alleybeachelectric/K3_KIOSK/fab file release/tplace-tname.PNG

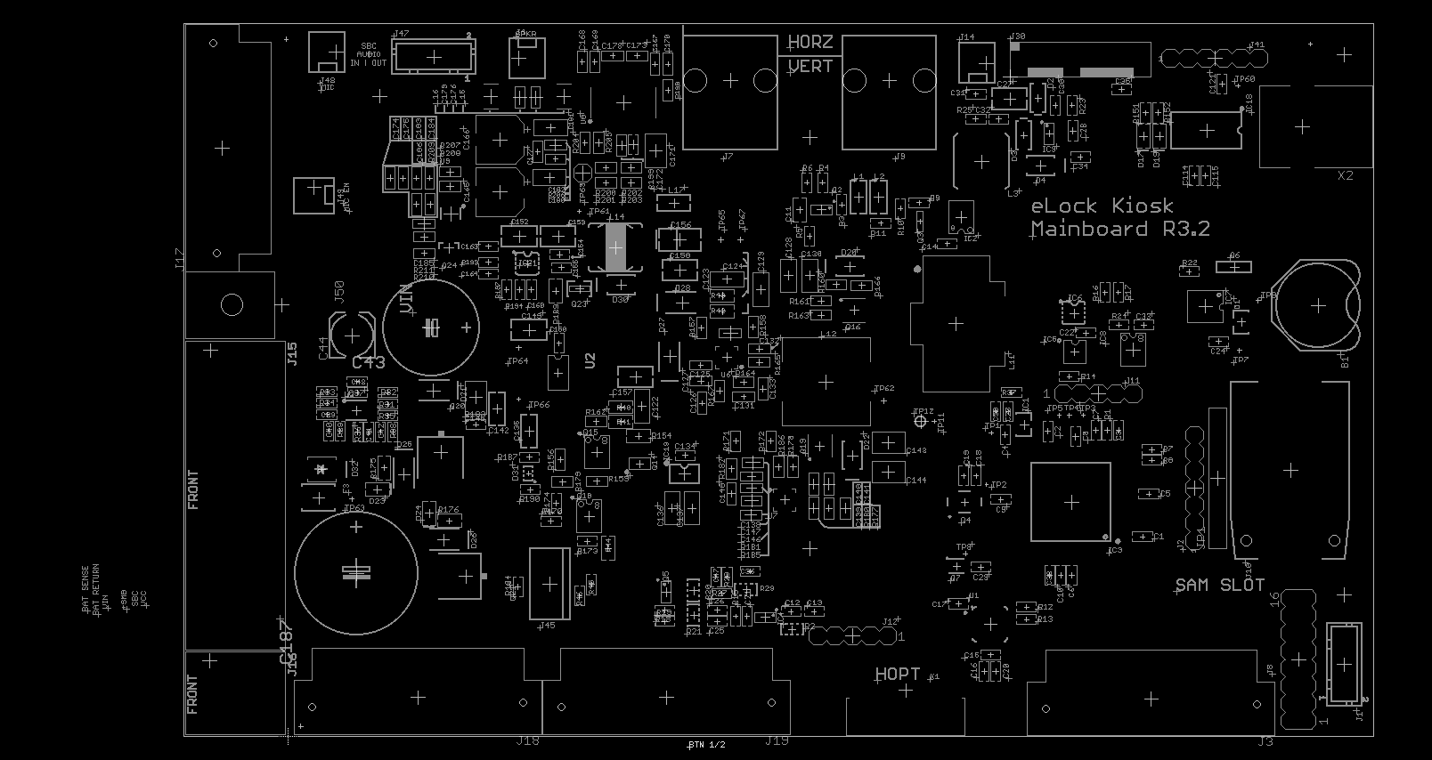
fab file release/tplace-tname.PNG
