alleybeachelectric/K3_KIOSK/fab file release/r3.3-05/BOM/PCB_KioskMB_r3.3-05 no attributes.csv

Qty | Value | Device | Package | Parts | Description
1 |  | P1-13 | P1-13@1 | TP69
4 |  | REF | REF | FID1, FID2, FID3, FID4
3 |  | ROUND_SMD0.7MM | SMD_ROUND_07MM | TP9, TP11, TP60 | Generic round SMD testpad
9 |  | ROUND_SMD1MM | SMD_ROUND_1MM | TP1, TP2, TP3, TP4, TP5, TP6, TP7, TP8, TP10 | Generic round SMD testpad
1 | FH12-22(10)SA-1SH | FH12-10S-0.5S1.00MM | CON-FPC-1.0MM-10POS | X1 | 0.5mm Pitch Connectors For FPC/FFC
5 | 0 | R-US_R0603 | R0603 | R16, R161, R163, R178, R180 | RESISTOR, American symbol
6 | 0.025R | R-0805 | 0805 | R40, R41, R42, R43, R44, R154
1 | 0.12R | R-0805 | 0805 | R189
26 | 0.1uF | C-0603 | 0603 | C2, C4, C5, C6, C17, C21, C22, C30, C33, C35, C37, C40, C42, C114, C121, C125, C126, C132, C139, C140, C147, C150, C154, C163, C167, C168
1 | 0.22R | R-0603 | 0603 | R26
5 | 0.47uF | C-0603 | 0603 | C173, C174, C175, C177, C178
1 | 0039301040 | 0039301040 | 0039301040 | J50 | MOLEX 2x2 Connector
2 | 0R | R-0603-0RTOP | 0603-0RTOP | R13, R15
4 | 1.0nF,50V | C-US-NP0603 | C0603 | C169, C170, C176, C179 | Capacitor, US symbol, non-polarized
5 | 10 | R-US_R0603 | R0603 | R157, R158, R171, R172, R198 | RESISTOR, American symbol
4 | 100K | R-0603 | 0603 | R7, R167, R186, R205
2 | 100pF | C-0603 | 0603 | C124, C138
1 | 100pF | C-US-NP0603 | C0603 | C146 | Capacitor, US symbol, non-polarized
10 | 10K | R-0603 | 0603 | R23, R25, R30, R31, R32, R33, R35, R162, R179, R193
8 | 10nF | C-0603 | 0603 | C12, C13, C25, C26, C36, C47, C134, C148
4 | 10uF,50V,1210 | C-US-NP1210 | C1210 | C143, C144, C145, C171 | Capacitor, US symbol, non-polarized
2 | 10uF/35V | C-1206 | 1206 | C135, C142
11 | 10uF/4V | C-0603 | 0603 | C3, C7, C9, C10, C23, C29, C38, C39, C41, C48, C59
1 | 120k | R-US_R0603 | R0603 | R209 | RESISTOR, American symbol
1 | 130pF,C0G | C-US-NP0603 | C0603 | C131 | Capacitor, US symbol, non-polarized
4 | 14011213102000 | 14011213102000 | 14011213102000 | J3, J17, J18, J19
1 | 15nF | C-US-NP0603 | C0603 | C133 | Capacitor, US symbol, non-polarized
1 | 15pF | C-0603 | 0603 | C160
2 | 178k,1% | R-US_R0603 | R0603 | R160, R177 | RESISTOR, American symbol
2 | 18pF | C-0603 | 0603 | C18, C19
1 | 1990737 | 1990737 | 1990737 | J16
1 | 1990834 | 1990834 | 1990834 | J15
3 | 1K | R-0603 | 0603 | R34, R36, R204
20 | 1M | R-0603 | 0603 | R3, R4, R5, R6, R9, R10, R11, R22, R24, R156, R159, R170, R173, R174, R183, R184, R197, R200, R201, R210
1 | 1nF | C-0603 | 0603 | C155
4 | 1u/10V | C-0603 | 0603 | C1, C8, C15, C24
1 | 1u/6.3V | C-0603 | 0603 | C14
2 | 1uF,25V | C-0603 | 0603 | C172, C182
3 | 1uF/16V | C-0603 | 0603 | C28, C31, C32
2 | 20.0k,1% | R-US_R0603 | R0603 | R166, R185 | RESISTOR, American symbol
1 | 22-11-2072 | HRXL-MAXSONAR-WRC-MB7387 | HRXL-MAXSONAR-WRC-MB7387 | J30
1 | 220pF | C-US-NP0603 | C0603 | C186 | Capacitor, US symbol, non-polarized
1 | 220uF, 16V, AL | CPOL-US153CLV-0605 | 153CLV-0605 | C44 | POLARIZED CAPACITOR, American symbol
2 | 220uF,16V,AL | CAP_ELEC_6.3MM_SMD | CAP_6.3MM_DIA_SMT | C165, C166
4 | 22u/16V | C-1210 | 1210 | C27, C149, C152, C153 | Capacitor 1210 3.2x2.5mm
9 | 22uF,25V,1206 | C-US-NP1206 | C1206 | C122, C123, C128, C129, C130, C136, C137, C180, C181 | Capacitor, US symbol, non-polarized
1 | 24LC32A-I/MS | 24-I/MS | MSOP-08 | IC6 | Serial EEPROM
1 | 2920L250DR | 1812L014DR | 1812 | F3 | PTC RESETTABLE 60V 140MA 1812L
1 | 2mF/16V | CPOL-USE7.5-18 | E7,5-18 | C187 | POLARIZED CAPACITOR, American symbol
4 | 3-641215-2 | 3-641215-2 | 3-641215-2 | J4, J14, J48, J49 | header 2 pin 100mil spacing
1 | 3-641215-4 | 3-641215-4 | 3-641215-4 | J45 | CONN HEADER VERT 4POS .100 30AU
1 | 3.09M | R-0603 | 0603 | R194
1 | 3.3K | R-0603 | 0603 | R207
2 | 3.3K | R-0805 | 0805 | R175, R176
3 | 3.3uF,16V | C-0603 | 0603 | C183, C184, C185
1 | 3.57K | R-0603 | 0603 | R8
1 | 3.9k | R-US_R0603 | R0603 | R211 | RESISTOR, American symbol
1 | 3001/3.3V | 3001 | 3001 | B1 | Through hole battery holder, 12mm cell, for BR1216, CR1216, BR1220, CL1220, CR1220, BR1225
2 | 300R | R-0603 | 0603 | R1, R37
1 | 330pF | C-0603 | 0603 | C164
1 | 33K | R-0603 | 0603 | R14
1 | 33R | R-0603 | 0603 | R206
1 | 4.7uF/16V | C-0805 | 0805 | C11
5 | 4.7uF/6.3V | C-0603 | 0603 | C16, C20, C115, C127, C141
1 | 470K | R-0603-0RTOP | 0603-0RTOP | R12
6 | 470R | R-0603 | 0603 | R38, R39, R45, R46, R151, R152
1 | 470uF/35-50V | CPOL-USE5-13 | E5-13 | C43 | POLARIZED CAPACITOR, American symbol
2 | 47K | R-0603 | 0603 | R187, R190
2 | 47uF/6.3V | C-1210 | 1210 | C157, C158 | Capacitor 1210 3.2x2.5mm
4 | 4x100K | EXB-38 | 0603-ARRAY | R2, R20, R21, R29 | Resistor array 4x
2 | 5.90K,1% | R-0603 | 0603 | R164, R181
1 | 6.8k | R-US_R0603 | R0603 | R208 | RESISTOR, American symbol
4 | 649R | R-0603 | 0603 | R18, R19, R27, R28
1 | 7B-28.63636MAAJ-T | 7B-27.120MAAJ-T | 7B | Q4 | Crystal 5x3.2mm, 18pF+-30ppm
2 | 93.1K,1% | R-0603 | 0603 | R165, R182
1 | ADS1015IDGS | ADS1015 | MSOP10 | U3 | 12-Bit Del-Sig ADC
1 | BAS70-05E6327 | BAS70-05E6327 | SOT-23 | D1 | Diode Schottky 70mA, 70V
1 | BAT54BRW-7F | BAT54BRW-7F | SOT-363 | D31 | DIODE SCHOTTKY 0.2A 30V ARR DL 30V SOT363
1 | BSS138 | BSS138 | SOT23 | Q24 | BSS138W N-chan MOSFET
1 | CCM03-3504LFT-NR | CCM03-3504LFT-NR | CCM03-3504LFT-NR | J10 | CONN SMART CARD FIXED 8PIN SMD
1 | CM519 32.768KDZF-UT | CM519 | CM519 | Q6
1 | CR75NP-220KC | CR75-330KC | CR75 | L14 | Inductor power, 27uH, 0.12R 1.3A, 33uH, 0.13R 1.2A
2 | CSD87331Q3D | TRANS_DUAL_NFET_HALF-BRQ3D | SON8_3.3X3.3_TI | Q16, Q19 | Dual n-chan MOSFETs half-bridge config, i.e. TI NexFET
2 | DF11-10DP-2DSA(01) | DF11-10DP-2DSA(01) | DF11-10DP-2DSA | J1, J47 | CONN HEADER 10POS 2MM PCB GOLD
2 | DNP | MA05-1 | MA05-1 | J11, J12
1 | DNP | MA06-1 | MA06-1 | J41
1 | DNP | MA07-1 | MA07-1 | J2
1 | DNP | PINHD-1X8LOCK | 1X08-LOCK | JP1 | PIN HEADER
2 | DNP | R-US_R0603 | R0603 | R202, R203 | RESISTOR, American symbol
1 | DNP | STPS0540Z | SOD-123 | D2 | Schottky diode 0.4V@0.5A 40Vrr, low Irr
1 | FDC6330L | FDC6324L | SSOT-6 | Q5 | IC LOAD SWITCH INT 20VIN SSOT-6
1 | FDC6330L | FDC6330L | SSOT-6 | Q2 | IC LOAD SWITCH INT 20VIN SSOT-6, 80mOhm, 2.5A
1 | FDN352AP | FDN352AP | SOT-23 | Q23 | MOSFET P 30V 1.3A 180mOhm@-10V
1 | FT232RL | FT232RL | SSOP28DB | IC18 | USB 2.0 to RS232 transfer interface IC
3 | HI1206T500R-00 | L-1206 | 1206 | L1, L2, L17
2 | HI1812V101R-10 | L1812 | L1812 | L15, L16 | Inductor, two pin
2 | IPD30N06S2L-23 | IPD30N06S2L-23 | TO252 | Q20, Q21 | MOSFET-N 55V 30A 0.023ohm
1 | ISL60002DIH325Z-TK | ISL60002DIH325Z-TK | SOT-23 | IC1 | Precision Low power V ref. Iq=350nA Vout=2.5V
1 | LE33CD | LE33 | LE33 | U2
4 | LED-GR | LED-0805 | 0805-POL | D17, D19, D23, D24
1 | LM3405AXMK/NOPB | LM3405AXMK/NOPB | SOT23-6 | IC9 | IC LED DRVR HP CONST TSOT23-6
1 | LM75ADP | LM75ADP | TSSOP08-3 | IC5 | Digital temperature sensor and thermal watchdog
1 | LTC1771EMS8 | LTC1771EMS8 | MSOP-08 | IC21 | Hi efficiency DCDC step down
1 | LTC1955 | LTC1955 | LFCSP_5X5_032 | U1 | Dual Smart Card interface with Serial control
1 | M25P16-VMN6P | M25P16-VMN6P | SO-08 | IC8 | 16Mbit low voltage SPI Flash
1 | MAX9938HEUK | TSM9938HEUK+T | SOT23-5 | Q14 | IC OPAMP CURRENT SENSE SOT23-5
1 | MCP602-I/ST | MCP6022-I/ST | TSSOP8 | IC19 | OPAMP 10MHz Vofset=0.5V
1 | MINI-USB_4P-85-32004-10X | MINI-USB_4P-85-32004-10X | 85-32004-10X | X2 | MINI USB 4 Pol.
1 | NRS8030T150MJGJ | NRS8030T150MJGJ | NRS8030 | L3 | Inductor power 150: 15uH 2.2A
1 | OPA322SAIDBVT | IC_TI_OPA322SAIDBV | SOT23-6 | U9 | TI OPA322S opamp with shutdown
1 | P6SMB16A | P6SMB16A | SMB | D32 | TVS Unidirectional 13.6V, 15.2-16.8V breakdown
1 | PCF2123TS/1-T | PCF2123TS/1-T | TSSOP014 | IC7 | RTC chip low power
1 | PIC10F200T-I/OT | PIC10F200T-I/OT | SOT23-6 | IC4 | IC MCU Flash 256B of FLASH
1 | PIC24FJ256GA110-I/PT | PIC24FJ256GA110-I/PT | SQFP-S-12X12-100 | IC3 | PIC24FJ256GA110
4 | PMEG3030BEP | PMEG3030BEP | SOD-128 | D4, D20, D22, D30 | DIODE SCHOTTKY 30V 3A SOD128
1 | SER2013-472MLD | LSER20XX | L_SER20XX | L11 | Inductor, two pin
2 | SI4564DY | SI4564DY | SO-08 | Q15, Q18 | MOSFET N/P-CH 40V 10A 8SOIC
1 | SMAJ26A | SMAJ5.0A | SMA | D21 | TVS 400W 5.0 Breakdown 6.40-7.25V
1 | SMAJ5.0A | SMAJ5.0A | SMA | D28 | TVS 400W 5.0 Breakdown 6.40-7.25V
1 | SMLVT3V3 | SMLVT3V3 | SMA | D27 | TVS 600W 4.1 Breakdown
1 | SN65HVD12D | SN65HVD3082ED | SO08 | IC2 | RS-422/485 TRX 1RX 1TX
1 | SR3.3.TCT | SR05.TCT | SOT-143 | Q3 | IC TVS ARRAY 2-LINE 5V SOT-143
1 | SRR1280-150M | LSRR1280 | L_SRR1280 | L12 | Inductor, two pin
2 | SS-6566-NF | SS-6566-NF | SS-6566-NF | J7, J9 | AMP CONNECTOR
2 | SS14 | SS14 | SMA | D25, D26 | Diode schottky If=1A
1 | SSM6P49NU,LFPZ | SSM6P49NU,LFPZ | MICRO_FET | Q7 | MOSFET P-CH DUAL 30V UDFN6, 4A, 20V
5 | STANDOFF_ELECTRICAL | STANDOFF_ELECTRICAL | STANDOFF-ELECTRICAL | H1, H2, H3, H4, H5 | Stand Off
1 | STPS0540Z | STPS0540Z | SOD-123 | D3 | Schottky diode 0.4V@0.5A 40Vrr, low Irr
1 | TCJB157M006R0045 | C-POL-3528 | 3528-POL | C156
1 | TPA3111D1PWP | IC_TI_TPA3111D1PWP | TSSOP28_EP | U8 | TI TPA3111D1 amp
7 | TPB1,27 | TPB1,27 | B1,27 | TP61, TP62, TP63, TP64, TP65, TP66, TP67 | Test pad
2 | TPS43061 | IC_TI_TPS43061RTE | QFN16_3X3_EP | U6, U7 | TI TPS43061 boost converter
1 | TP_0812 | TP_0812 | TP_0.8_1.2 | TP12 | Testpad hole 0.8mm (32mil)
1 | TSW-108-07-G-D | MA08-2 | MA08-2 | J8
1 | dnp | C-0603 | 0603 | C34
