alleybeachelectric/K3_KIOSK/BOARD FILES/PCB_KioskMB_r3.2.dxf

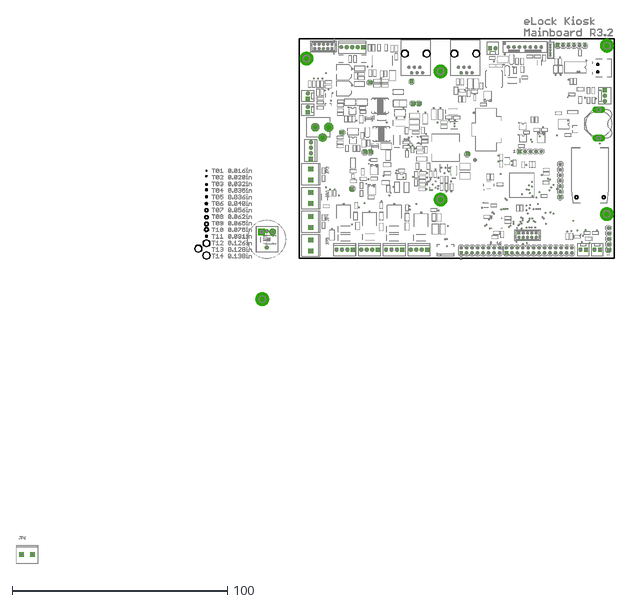
[picture p2: CAD file, 2017-05-18]
BOARD FILES/PCB_KioskMB_r3.2.dxf
277.7 x 254.3
