alleybeachelectric/K3_KIOSK/PDF's/PCB_KioskMB_r3.2- fixed FPC connector.dxf

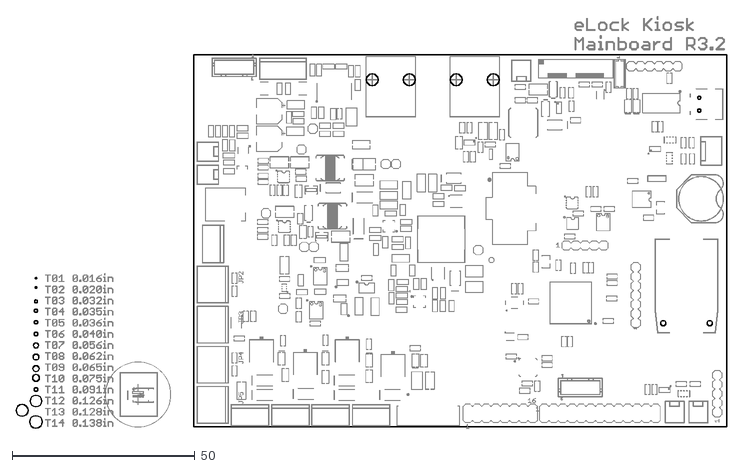
[picture p3: CAD file, 2017-05-18]
PDF's/PCB_KioskMB_r3.2- fixed FPC connector.dxf
194.7 x 113.0
