alleybeachelectric/K3_KIOSK/PDF's/PCB_KioskMB_r3.3-03 SILK 3.pdf

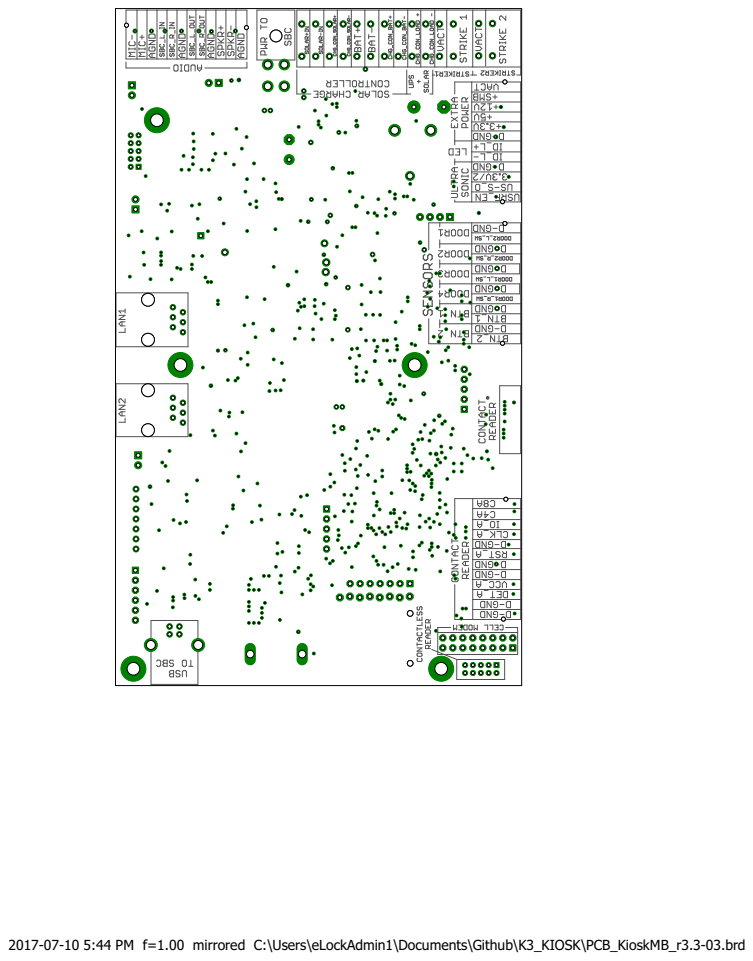
[picture p4: page 1]

2017-07-10 5:44 PM f=1.00 mirrored C:\Users\eLockAdmin1\Documents\Github\K3_KIOSK\PCB_KioskMB_r3.3-03.brd
