alleybeachelectric/K3_KIOSK/PDF's/PCB_KioskMB_r3.3-03 SILK4.pdf

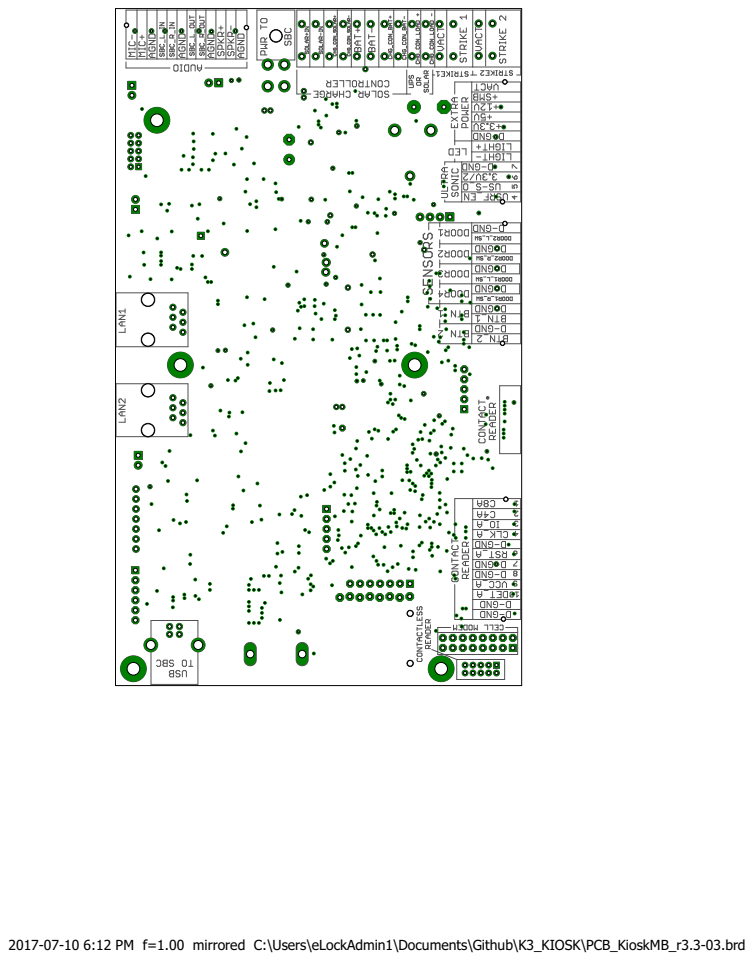
[picture p6: page 1]

2017-07-10 6:12 PM f=1.00 mirrored C:\Users\eLockAdmin1\Documents\Github\K3_KIOSK\PCB_KioskMB_r3.3-03.brd
