alleybeachelectric/K3_KIOSK/BOARD FILES/PCB_KioskMB_r3.3-04.brd

## EAGLE design BOARD FILES/PCB_KioskMB_r3.3-04.brd (2017-07-11)

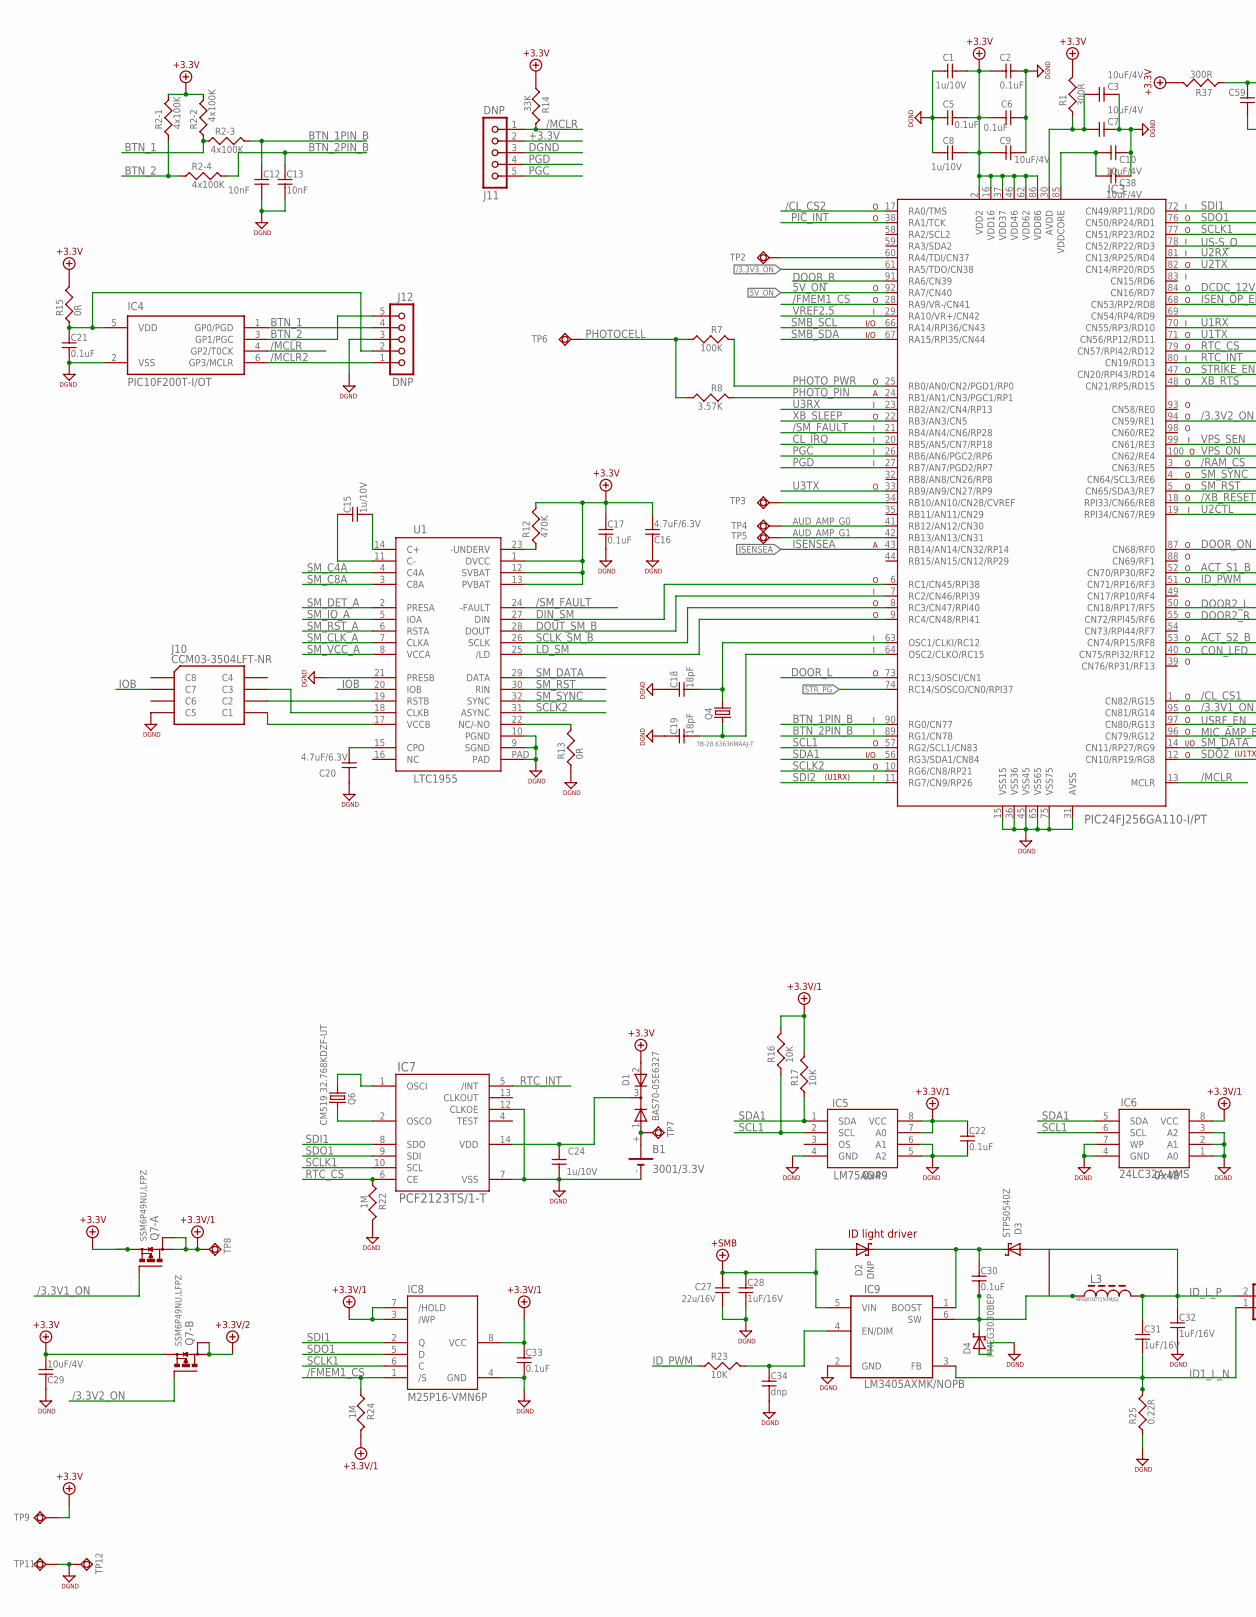
[picture p11: schematic PCB_KioskMB_r3.3-04.sch, sheet 1, part in row 1, column 1]

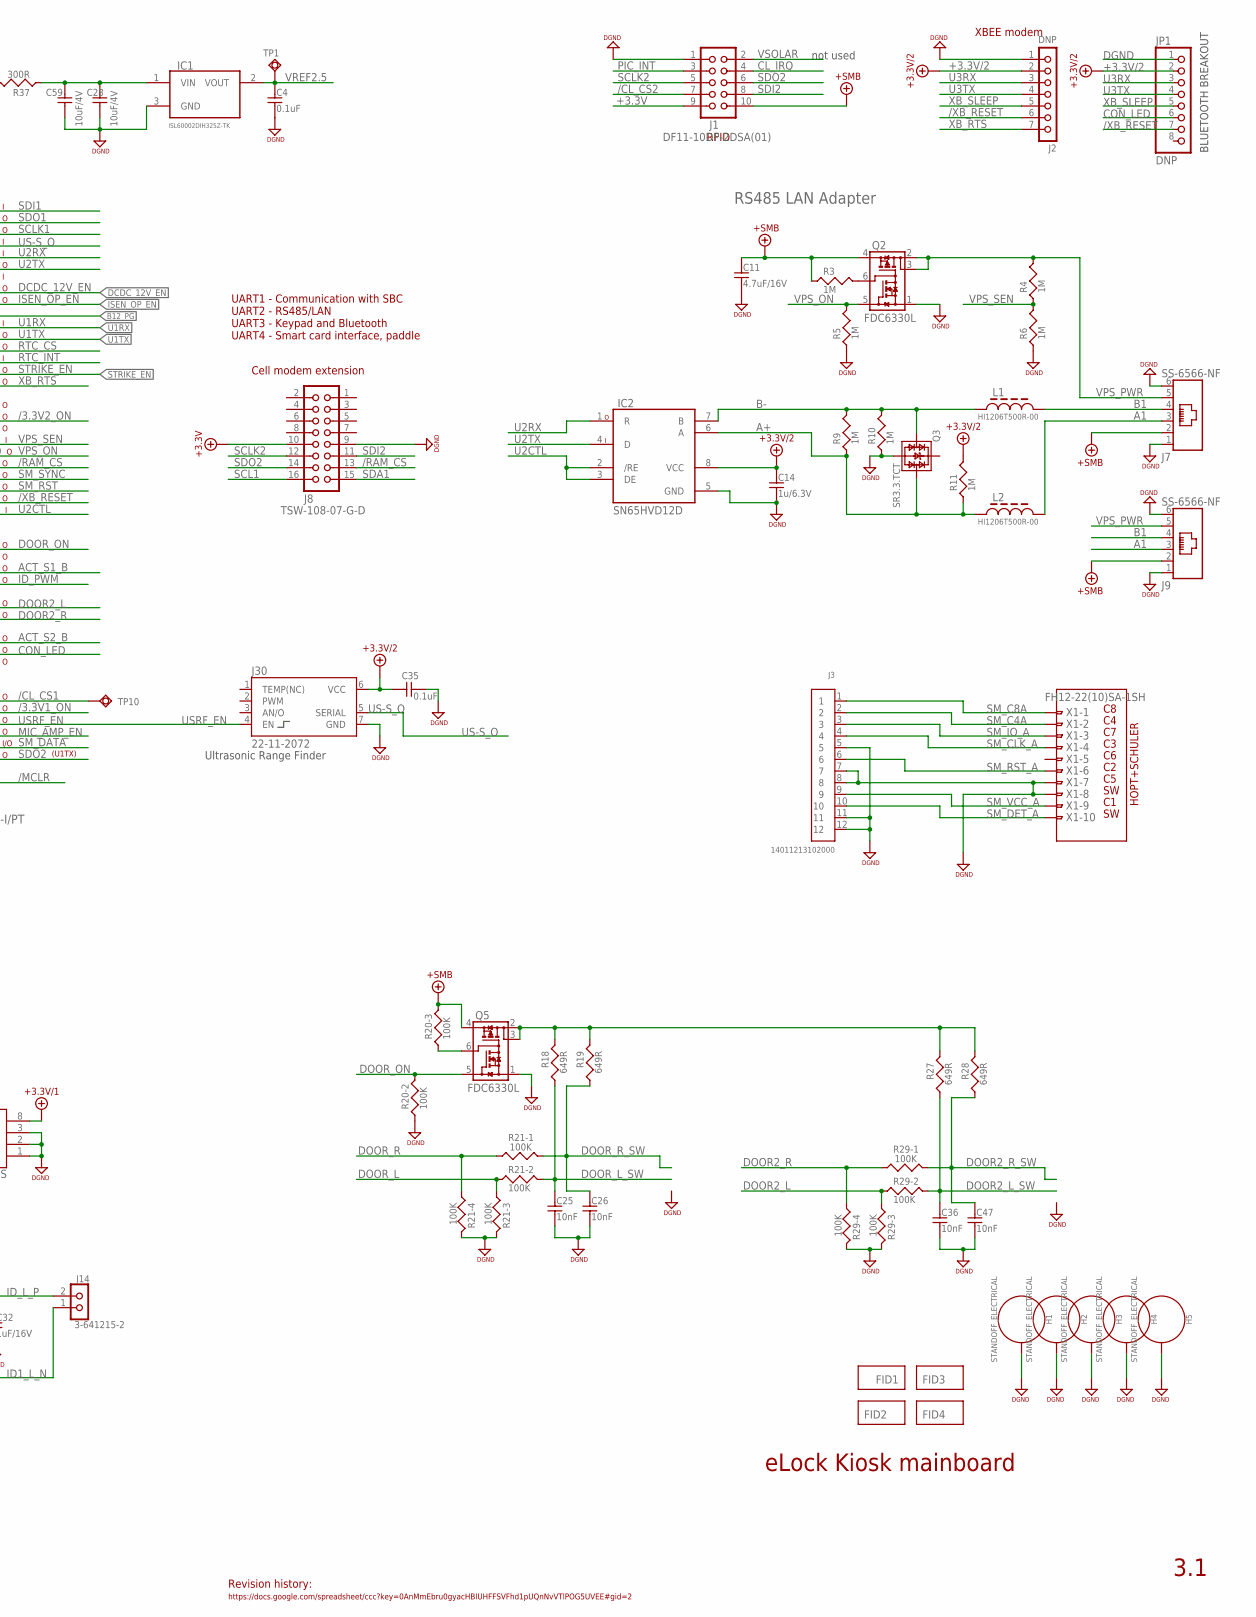
[picture p12: schematic PCB_KioskMB_r3.3-04.sch, sheet 1, part in row 1, column 2]

Parts:
B1: 3001/3.3V; 3001
C1, C8, C15, C24: 1u/10V; 0603
C2, C4, C5, C6, C17, C21, C22, C30, C33, C35: 0.1uF; 0603
C3, C7, C9, C10, C23, C29, C38, C59: 10uF/4V; 0603
C11: 4.7uF/16V; 0805
C12, C13, C25, C26, C36, C47: 10nF; 0603
C14: 1u/6.3V; 0603
C16, C20: 4.7uF/6.3V; 0603
C18, C19: 18pF; 0603
C27: 22u/16V; 1210
C28, C31, C32: 1uF/16V; 0603
C34: dnp; 0603
D1: BAS70-05E6327; SOT-23
D2: DNP; SOD-123
D3: STPS0540Z; SOD-123
D4: PMEG3030BEP; SOD-128
FID1, FID2, FID3, FID4: REF
H1, H2, H3, H4, H5: STANDOFF_ELECTRICAL; STANDOFF-ELECTRICAL
IC1: ISL60002DIH325Z-TK; SOT-23
IC2: SN65HVD12D; SO08
IC3: PIC24FJ256GA110-I/PT; SQFP-S-12X12-100
IC4: PIC10F200T-I/OT; SOT23-6
IC5: LM75ADP; TSSOP08-3
IC6: 24LC32A-I/MS; MSOP-08
IC7: PCF2123TS/1-T; TSSOP014
IC8: M25P16-VMN6P; SO-08
IC9: LM3405AXMK/NOPB; SOT23-6
J1: DF11-10DP-2DSA(01); DF11-10DP-2DSA
J2: DNP; MA07-1
J3: 14011213102000
J7, J9: SS-6566-NF
J8: TSW-108-07-G-D; MA08-2
J10: CCM03-3504LFT-NR
J11, J12: DNP; MA05-1
J14: 3-641215-2
J30: 22-11-2072; HRXL-MAXSONAR-WRC-MB7387
JP1: DNP; 1X08-LOCK
L1, L2: HI1206T500R-00; 1206
L3: NRS8030T150MJGJ; NRS8030
Q2, Q5: FDC6330L; SSOT-6
Q3: SR3.3.TCT; SOT-143
Q4: 7B-28.63636MAAJ-T; 7B
Q6: CM519 32.768KDZF-UT; CM519
Q7: SSM6P49NU,LFPZ; MICRO_FET
R1, R37: 300R; 0603
R2: 4x100K; 0603-ARRAY
R3, R4, R5, R6, R9, R10, R11, R22, R24: 1M; 0603
R7: 100K; 0603
R8: 3.57K; 0603
R12: 470K; 0603-0RTOP
R13, R15: 0R; 0603-0RTOP
R14: 33K; 0603
R16, R17, R23: 10K; 0603-0RTOP
R18, R19, R27, R28: 649R; 0603
R20, R21, R29: 100K; 0603-ARRAY
R25: 0.22R; 0603-0RTOP
TP1, TP2, TP3, TP4, TP5, TP6, TP7, TP8, TP10: ROUND_SMD1MM; SMD_ROUND_1MM
TP9, TP11: ROUND_SMD0.7MM; SMD_ROUND_07MM
TP12: TP_0812; TP_0.8_1.2
U1: LTC1955; LFCSP_5X5_032
X1: FH12-22(10)SA-1SH; CON-FPC-1.0MM-10POS

Connections:
5V_ON: IC3.92 (RA7/CN40); also elsewhere on the board
+3.3V: C1.1, C2.1, C5.1, C6.1, C8.1, C9.1, C16.2, C17.1, C29.2, D1.2 (A2), IC3.2 (VDD2), IC3.16 (VDD16), IC3.37 (VDD37), IC3.46 (VDD46), IC3.62 (VDD62), IC3.86 (VDD86), J1.9, J8.10, J11.2, Q7.1 (S), Q7.4 (S), R1.2, R2.7 (2), R2.8 (2), R12.2, R14.2, R15.2, R37.2, TP9.P$1, U1.1 (DVCC), U1.12 (SVBAT), U1.13 (PVBAT); also elsewhere on the board
+3.3V/1: C22.1, C33.1, IC5.7 (A0), IC5.8 (VCC), IC6.8 (VCC), IC8.3 (/WP), IC8.7 (/HOLD), IC8.8 (VCC), Q7.6 (D), Q7.P1 (D1), R16.2, R17.2, R24.1, TP8.P$1; also elsewhere on the board
+3.3V/2: C14.1, C35.2, IC2.8 (VCC), J2.2, J30.6 (VCC), JP1.2, Q7.3 (D), Q7.P2 (D1), R11.2; also elsewhere on the board
+SMB: C11.1, C27.1, C28.1, D2.A, IC9.5 (VIN), J1.10, J7.2, J9.2, Q2.4 (Q2S), Q5.4 (Q2S), R3.1, R20.6 (2); also elsewhere on the board
/3.3V1_ON: IC3.95 (CN81/RG14), Q7.2 (G)
/3.3V2_ON: IC3.94 (CN59/RE1), Q7.5 (G)
/3.3V3_ON: IC3.61 (RA5/TDO/CN38)
/CL_CS1: IC3.1 (CN82/RG15), TP10.P$1
/CL_CS2: IC3.17 (RA0/TMS), J1.7
/FMEM1_CS: IC3.28 (RA9/VR-/CN41), IC8.1 (/S), R24.2
/MCLR: IC3.13 (MCLR), IC4.4 (GP2/T0CK), J11.1, R14.1
/MCLR2: IC4.6 (GP3/MCLR), J12.1
/RAM_CS: IC3.3 (CN63/RE5), J8.13
/SM_FAULT: IC3.21 (RB4/AN4/CN6/RP28), U1.24 (-FAULT)
/XB_RESET: IC3.18 (RPI33/CN66/RE8), J2.6, JP1.7
A1: J7.3, J9.3, L2.2
A+: IC2.6 (A), L2.1, Q3.3, R9.1, R11.1
ACT_S1_B: IC3.52 (CN70/RP30/RF2); also elsewhere on the board
ACT_S2_B: IC3.53 (CN74/RP15/RF8); also elsewhere on the board
AUD_AMP_G0: IC3.41 (RB12/AN12/CN30), TP4.P$1; also elsewhere on the board
AUD_AMP_G1: IC3.42 (RB13/AN13/CN31), TP5.P$1; also elsewhere on the board
B1: J7.4, J9.4, L1.2
B12_PG: IC3.69 (CN54/RP4/RD9); also elsewhere on the board
B-: IC2.7 (B), L1.1, Q3.2, R9.2, R10.2
BTN_1: IC4.1 (GP0/PGD), J12.4, R2.2 (1), R2.3 (1); also elsewhere on the board
BTN_1PIN_B: C12.1, IC3.90 (RG0/CN77), R2.6 (2)
BTN_2: IC4.3 (GP1/PGC), J12.5, R2.1, R2.4 (1); also elsewhere on the board
BTN_2PIN_B: C13.1, IC3.89 (RG1/CN78), R2.5 (2)
CL_IRQ: IC3.20 (RB5/AN5/CN7/RP18), J1.4
CON_LED: IC3.40 (CN75/RPI32/RF12), JP1.6
DCDC_12V_EN: IC3.84 (CN16/RD7); also elsewhere on the board
DGND: B1.-, C1.2, C2.2, C3.2, C4.2, C5.2, C6.2, C7.2, C8.2, C9.2, C10.1, C11.2, C12.2, C13.2, C14.2, C16.1, C17.2, C18.1, C19.1, C20.1, C21.2, C22.2, C23.2, C24.2, C25.2, C26.2, C27.2, C28.2, C29.1, C32.2, C33.2, C34.2, C35.1, C36.2, C38.1, C47.2, C59.2, D4.A, H1.P1, H2.P1, H3.P1, H4.P1, H5.P1, IC1.3 (GND), IC2.5 (GND), IC3.15 (VSS15), IC3.31 (AVSS), IC3.36 (VSS36), IC3.45 (VSS45), IC3.65 (VSS65), IC3.75 (VSS75), IC4.2 (VSS), IC5.4 (GND), IC5.5 (A2), IC5.6 (A1), IC6.1 (A0), IC6.2 (A1), IC6.3 (A2), IC6.4 (GND), IC6.7 (WP), IC7.7 (VSS), IC7.12 (CLKOE), IC8.4 (GND), IC9.2 (GND), J1.1, J2.1, J3.5, J3.7, J3.8, J3.11, J3.12, J7.1, J7.6, J8.9, J9.1, J9.6, J10.C5, J11.3, J12.3, J30.7 (GND), JP1.1, Q2.1 (Q1S), Q3.1, Q5.1 (Q1S), R5.1, R6.1, R10.1, R13.1, R20.2 (1), R21.5 (2), R21.6 (2), R22.1, R25.1, R29.5 (2), R29.6 (2), TP11.P$1, TP12.1, U1.9 (SGND), U1.10 (PGND), U1.21 (PRESB), U1.PAD, X1.7, X1.8; also elsewhere on the board
DIN_SM: IC3.6 (RC1/CN45/RPI38), U1.27 (DIN)
DOOR2_L: IC3.50 (CN18/RP17/RF5), R29.2 (1), R29.3 (1)
DOOR2_L_SW: C36.1, R27.2, R29.7 (2); also elsewhere on the board
DOOR2_R: IC3.55 (CN72/RPI45/RF6), R29.1, R29.4 (1)
DOOR2_R_SW: C47.1, R28.2, R29.8 (2); also elsewhere on the board
DOOR_L: IC3.73 (RC13/SOSCI/CN1), R21.2 (1), R21.3 (1)
DOOR_L_SW: C25.1, R18.2, R21.7 (2); also elsewhere on the board
DOOR_ON: IC3.87 (CN68/RF0), Q5.5 (Q1G), R20.7 (2)
DOOR_R: IC3.91 (RA6/CN39), R21.1, R21.4 (1)
DOOR_R_SW: C26.1, R19.2, R21.8 (2); also elsewhere on the board
DOUT_SM_B: IC3.7 (RC2/CN46/RPI39), U1.28 (DOUT)
ID1_L_N: C31.2, IC9.3 (FB), J14.1, R25.2; also elsewhere on the board
ID_L_P: C31.1, C32.1, D3.A, J14.2, L3.2; also elsewhere on the board
ID_PWM: IC3.51 (CN71/RP16/RF3), R23.1
IOB: J10.C7, U1.20 (IOB)
ISENSEA: IC3.43 (RB14/AN14/CN32/RP14); also elsewhere on the board
ISEN_OP_EN: IC3.68 (CN53/RP2/RD8); also elsewhere on the board
LD_SM: IC3.9 (RC4/CN48/RPI41), U1.25 (/LD)
MIC_AMP_EN: IC3.96 (CN79/RG12); also elsewhere on the board
unnamed: C10.2, C38.2, IC3.85 (VDDCORE)
unnamed: C20.2, U1.15 (CPO)
unnamed: B1.+, D1.1 (A1), TP7.P$1
unnamed: J10.C2, U1.19 (RSTB)
unnamed: C19.2, IC3.64 (OSC2/CLKO/RC15), Q4.1
unnamed: C15.1, U1.11 (C-)
unnamed: C15.2, U1.14 (C+)
unnamed: C24.1, D1.3 (K), IC7.14 (VDD)
unnamed: R12.1, U1.23 (-UNDERV)
unnamed: IC7.1 (OSCI), Q6.2
unnamed: IC7.2 (OSCO), Q6.1
unnamed: R13.2, U1.22 (NC/-NO)
unnamed: J10.C3, U1.18 (CLKB)
unnamed: J10.C1, U1.17 (VCCB)
unnamed: Q5.6 (Q2G), R20.3 (1)
unnamed: C18.2, IC3.63 (OSC1/CLKI/RC12), Q4.3 (2)
unnamed: C23.1, C59.1, IC1.1 (VIN), R37.1
unnamed: Q5.2 (Q2D1), Q5.3 (Q2D2), R18.1, R19.1, R27.1, R28.1
unnamed: C21.1, IC4.5 (VDD), J12.2, R15.1
unnamed: IC3.34 (RB10/AN10/CN28/CVREF), TP3.P$1
unnamed: C3.1, C7.1, IC3.30 (AVDD), R1.1
unnamed: IC3.60 (RA4/TDI/CN37), TP2.P$1
unnamed: C34.1, IC9.4 (EN/DIM), R23.2
unnamed: C30.2, D4.K, IC9.6 (SW), L3.1
unnamed: C30.1, D2.C (K), D3.C (K), IC9.1 (BOOST)
unnamed: Q2.6 (Q2G), R3.2
PGC: IC3.26 (RB6/AN6/PGC2/RP6), J11.5
PGD: IC3.27 (RB7/AN7/PGD2/RP7), J11.4
PHOTOCELL: R7.2, R8.2, TP6.P$1
PHOTO_PIN: IC3.24 (RB1/AN1/CN3/PGC1/RP1), R8.1
PHOTO_PWR: IC3.25 (RB0/AN0/CN2/PGD1/RP0), R7.1
PIC_INT: IC3.38 (RA1/TCK), J1.3
RTC_CS: IC3.79 (CN57/RPI42/RD12), IC7.6 (CE), R22.2
RTC_INT: IC3.80 (CN19/RD13), IC7.5 (/INT)
SCL1: IC3.57 (RG2/SCL1/CN83), IC5.2 (SCL), IC6.6 (SCL), J8.16, R16.1; also elsewhere on the board
SCLK1: IC3.77 (CN51/RP23/RD2), IC7.10 (SCL), IC8.6 (C)
SCLK2: IC3.10 (RG6/CN8/RP21), J1.5, J8.12, U1.31 (ASYNC)
SCLK_SM_B: IC3.8 (RC3/CN47/RPI40), U1.26 (SCLK)
SDA1: IC3.56 (RG3/SDA1/CN84), IC5.1 (SDA), IC6.5 (SDA), J8.15, R17.1; also elsewhere on the board
SDI1: IC3.72 (CN49/RP11/RD0), IC7.8 (SDO), IC8.2 (Q)
SDI2: IC3.11 (RG7/CN9/RP26), J1.8, J8.11
SDO1: IC3.76 (CN50/RP24/RD1), IC7.9 (SDI), IC8.5 (D)
SDO2: IC3.12 (CN10/RP19/RG8), J1.6, J8.14
SMB_SCL: IC3.66 (RA14/RPI36/CN43); also elsewhere on the board
SMB_SDA: IC3.67 (RA15/RPI35/CN44); also elsewhere on the board
SM_C4A: J3.2, U1.4 (C4A), X1.2
SM_C8A: J3.1, U1.3 (C8A), X1.1
SM_CLK_A: J3.4, U1.7 (CLKA), X1.4
SM_DATA: IC3.14 (CN11/RP27/RG9), U1.29 (DATA)
SM_DET_A: J3.10, U1.2 (PRESA), X1.10
SM_IO_A: J3.3, U1.5 (IOA), X1.3
SM_RST: IC3.5 (CN65/SDA3/RE7), U1.30 (RIN)
SM_RST_A: J3.6, U1.6 (RSTA), X1.6
SM_SYNC: IC3.4 (CN64/SCL3/RE6), U1.32 (SYNC)
SM_VCC_A: J3.9, U1.8 (VCCA), X1.9
STRIKE_EN: IC3.47 (CN20/RPI43/RD14); also elsewhere on the board
STR_PG: IC3.74 (RC14/SOSCO/CN0/RPI37); also elsewhere on the board
U1RX: IC3.70 (CN55/RP3/RD10); also elsewhere on the board
U1TX: IC3.71 (CN56/RP12/RD11); also elsewhere on the board
U2CTL: IC2.2 (/RE), IC2.3 (DE), IC3.19 (RPI34/CN67/RE9)
U2RX: IC2.1 (R), IC3.81 (CN13/RP25/RD4)
U2TX: IC2.4 (D), IC3.82 (CN14/RP20/RD5)
U3RX: IC3.23 (RB2/AN2/CN4/RP13), J2.3, JP1.3
U3TX: IC3.33 (RB9/AN9/CN27/RP9), J2.4, JP1.4
US-S_O: IC3.78 (CN52/RP22/RD3), J30.5 (SERIAL); also elsewhere on the board
USRF_EN: IC3.97 (CN80/RG13), J30.4 (EN); also elsewhere on the board
VPS_ON: IC3.100 (CN62/RE4), Q2.5 (Q1G), R5.2
VPS_PWR: J7.5, J9.5, Q2.2 (Q2D1), Q2.3 (Q2D2), R4.2
VPS_SEN: IC3.99 (CN61/RE3), R4.1, R6.2
VREF2.5: C4.1, IC1.2 (VOUT), IC3.29 (RA10/VR+/CN42), TP1.P$1
VSOLAR: J1.2
XB_RTS: IC3.48 (CN21/RP5/RD15), J2.7
XB_SLEEP: IC3.22 (RB3/AN3/CN5), J2.5, JP1.5

Notes on the sheet:
Cell modem extension
XBEE modem
I/O
3.1
eLock Kiosk mainboard
(U1RX)
(U1TX)
Revision history:
https://docs.google.com/spreadsheet/ccc?key=0AnMmEbru0gyacHBIUHFFSVFhd1pUQnNvVTlPOG5UVEE#gid=2
ID light driver
UART1 - Communication with SBC UART2 - RS485/LAN UART3 - Keypad and Bluetooth UART4 - Smart card interface, paddle
RS485 LAN Adapter
Ultrasonic Range Finder
HOPT+SCHULER
0x49
0x48
RFID
BLUETOOTH BREAKOUT
not used

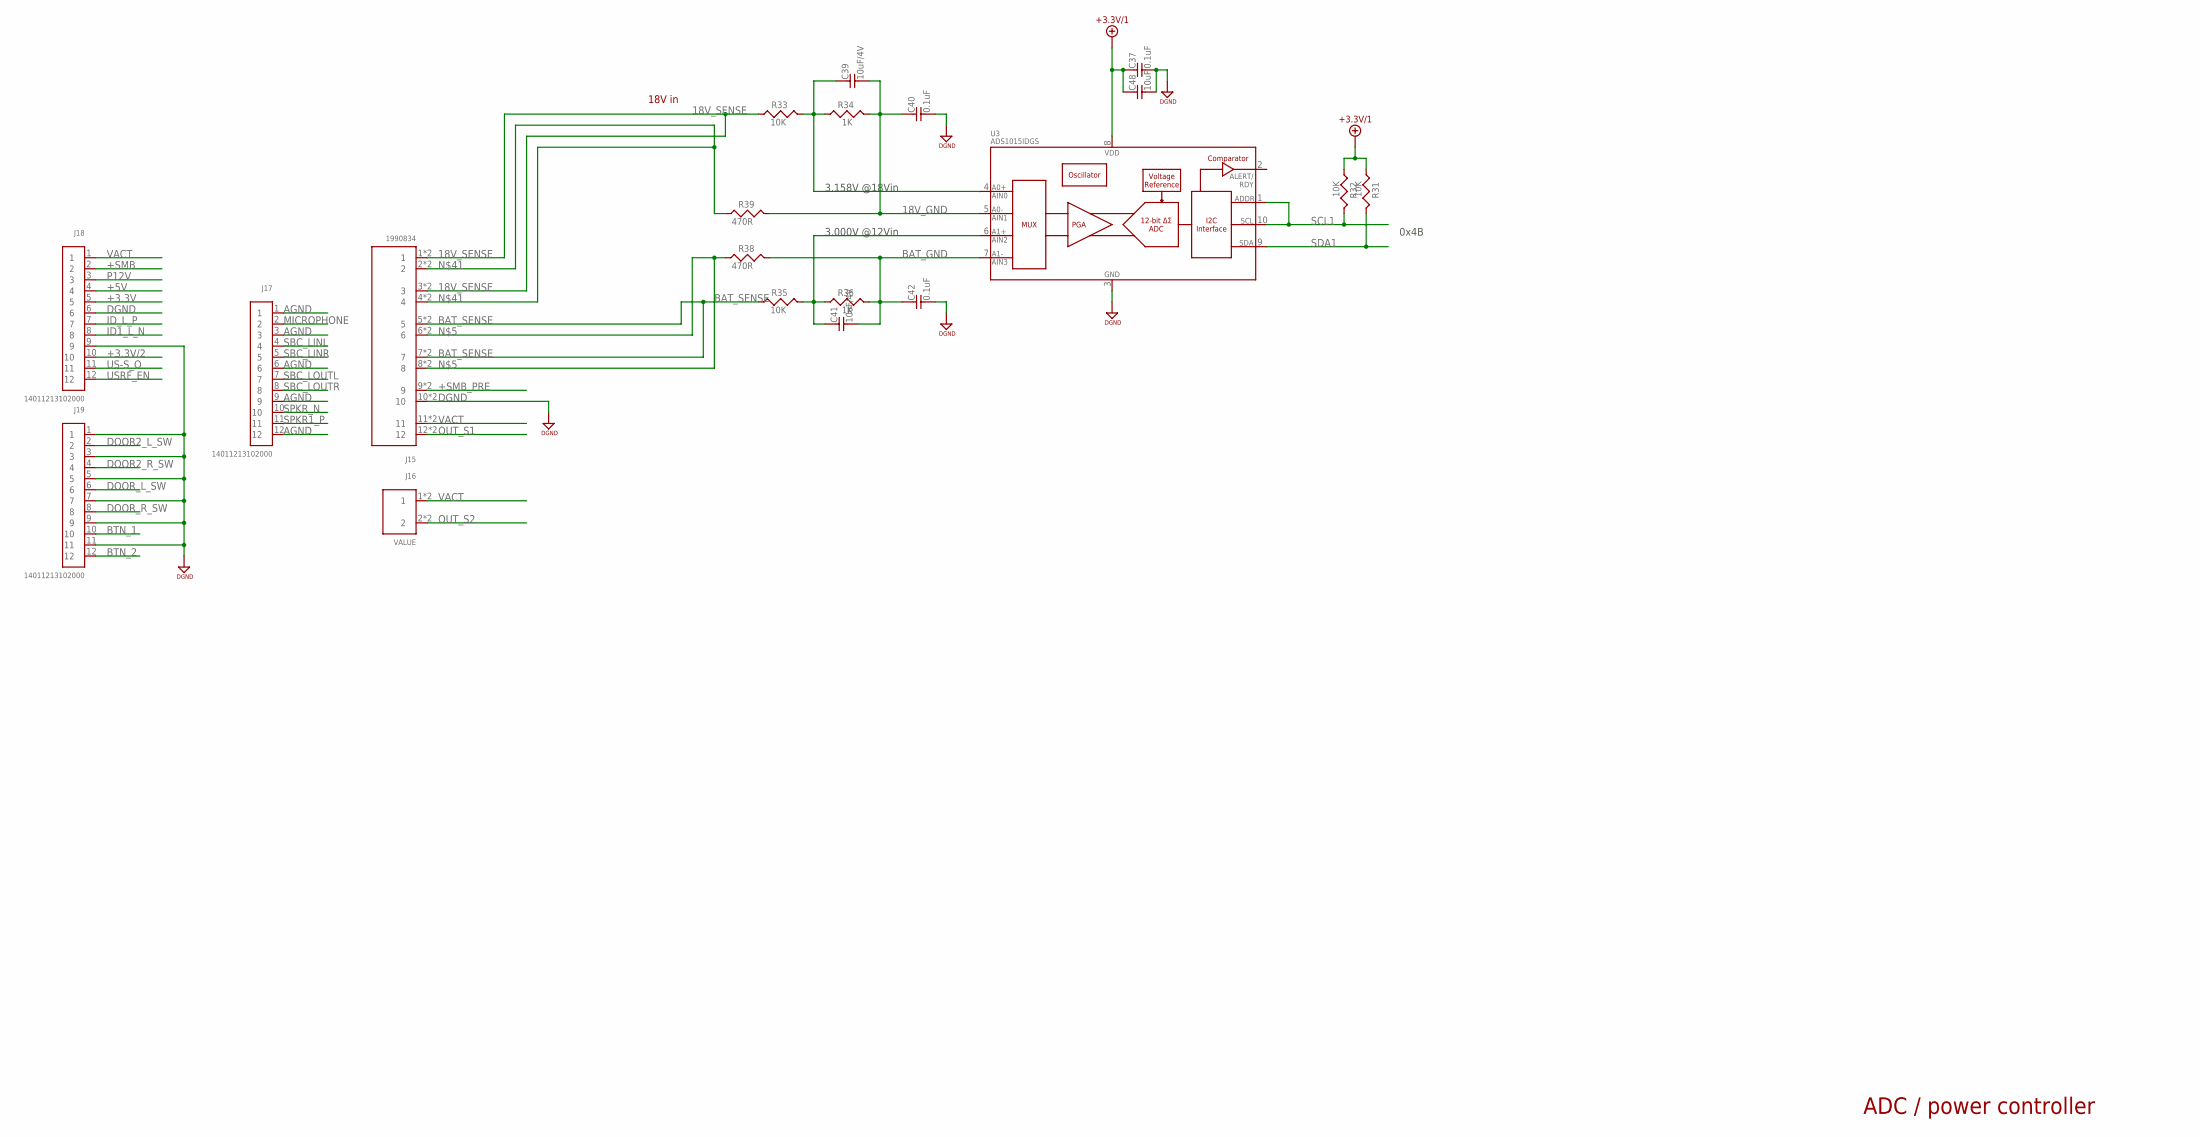
[picture p13: schematic PCB_KioskMB_r3.3-04.sch, sheet 2]

Parts:
C37, C40, C42: 0.1uF; 0603
C39, C41: 10uF/4V; 0603
C48: 10uF; 0603
J15: 1990834
J16: 1990737
J17, J18, J19: 14011213102000
R31, R32, R33, R35: 10K; 0603
R34, R36: 1K; 0603
R38, R39: 470R; 0603
U3: ADS1015IDGS; MSOP10

Connections:
18V_GND: C39.2, C40.1, R34.1, R39.1, U3.5 (AIN1)
18V_SENSE: J15.1, J15.1A (1), J15.3, J15.3A (3), R33.2
+3.3V: J18.5; also elsewhere on the board
+3.3V/1: C37.1, C48.1, R31.2, R32.2, U3.8 (VDD); also elsewhere on the board
+3.3V/2: J18.10; also elsewhere on the board
+5V: J18.4; also elsewhere on the board
+SMB: J18.2; also elsewhere on the board
+SMB_PRE: J15.9, J15.9A (9); also elsewhere on the board
AGND: J17.1, J17.3, J17.6, J17.9, J17.12; also elsewhere on the board
BAT_GND: C41.2, C42.1, R36.1, R38.1, U3.7 (AIN3)
BAT_SENSE: J15.5, J15.5A (5), J15.7, J15.7A (7), R35.2
BTN_1: J19.10; also elsewhere on the board
BTN_2: J19.12; also elsewhere on the board
DGND: C37.2, C40.2, C42.2, C48.2, J15.10, J15.10A (10), J18.6, J18.9, J19.1, J19.3, J19.5, J19.7, J19.9, J19.11, U3.3 (VSS); also elsewhere on the board
DOOR2_L_SW: J19.2; also elsewhere on the board
DOOR2_R_SW: J19.4; also elsewhere on the board
DOOR_L_SW: J19.6; also elsewhere on the board
DOOR_R_SW: J19.8; also elsewhere on the board
ID1_L_N: J18.8; also elsewhere on the board
ID_L_P: J18.7; also elsewhere on the board
MICROPHONE: J17.2; also elsewhere on the board
unnamed: J15.6, J15.6A (6), J15.8, J15.8A (8), R38.2
unnamed: C39.1, R33.1, R34.2, U3.4 (AIN0)
unnamed: C41.1, R35.1, R36.2, U3.6 (AIN2)
unnamed: J15.2, J15.2A (2), J15.4, J15.4A (4), R39.2
OUT_S1: J15.12, J15.12A (12); also elsewhere on the board
OUT_S2: J16.2, J16.2A (2); also elsewhere on the board
P12V: J18.3; also elsewhere on the board
SBC_LINL: J17.4; also elsewhere on the board
SBC_LINR: J17.5; also elsewhere on the board
SBC_LOUTL: J17.7; also elsewhere on the board
SBC_LOUTR: J17.8; also elsewhere on the board
SCL1: R32.1, U3.1 (ADDR), U3.10 (SCL); also elsewhere on the board
SDA1: R31.1, U3.9 (SDA); also elsewhere on the board
SPKR1_P: J17.11; also elsewhere on the board
SPKR_N: J17.10; also elsewhere on the board
US-S_O: J18.11; also elsewhere on the board
USRF_EN: J18.12; also elsewhere on the board
VACT: J15.11, J15.11A (11), J16.1, J16.1A (1), J18.1; also elsewhere on the board

Notes on the sheet:
ADC / power controller
0x4B
18V in
3.158V @18Vin
3.000V @12Vin

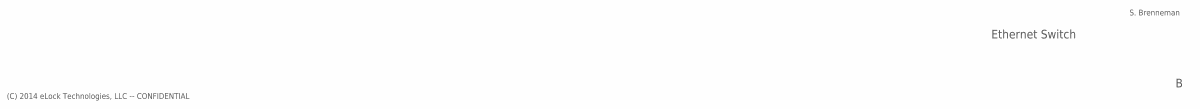
[picture p14: schematic PCB_KioskMB_r3.3-04.sch, sheet 3]

Notes on the sheet:
(C) 2014 eLock Technologies, LLC -- CONFIDENTIAL
S. Brenneman
Ethernet Switch

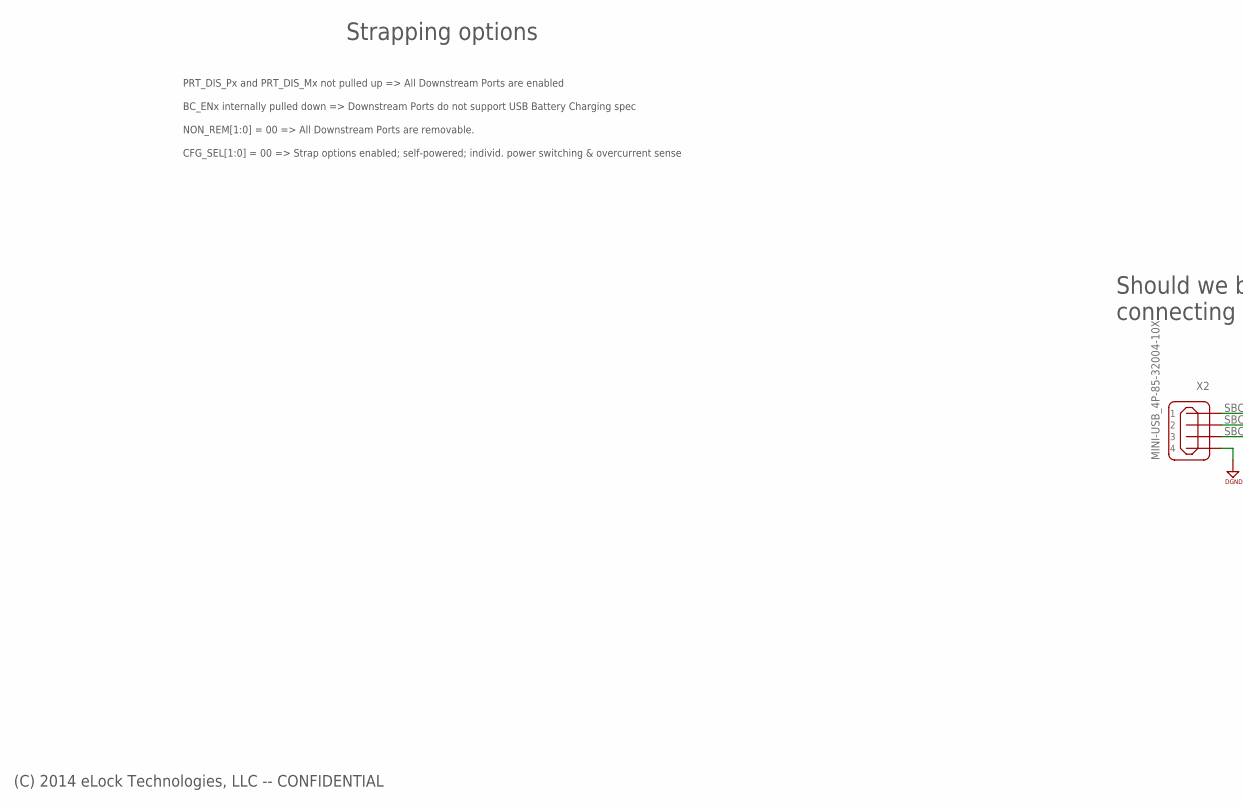
[picture p15: schematic PCB_KioskMB_r3.3-04.sch, sheet 4, part in row 1, column 1]

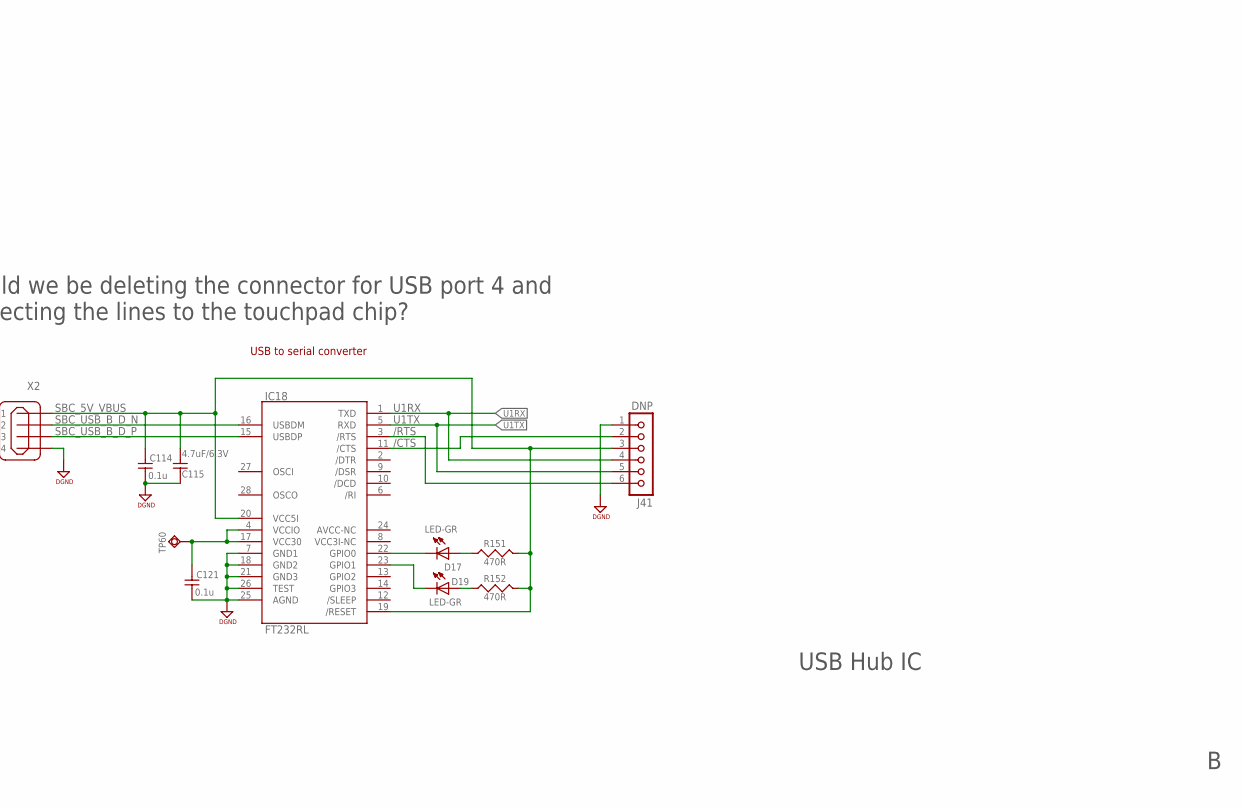
[picture p16: schematic PCB_KioskMB_r3.3-04.sch, sheet 4, part in row 1, column 2]

Parts:
C114, C121: 0.1u; 0603
C115: 4.7uF/6.3V; 0603
D17, D19: LED-GR; 0805-POL
IC18: FT232RL; SSOP28DB
J41: DNP; MA06-1
R151, R152: 470R; 0603
TP60: ROUND_SMD0.7MM; SMD_ROUND_07MM
X2: MINI-USB_4P-85-32004-10X; 85-32004-10X

Connections:
/CTS: IC18.11 (/CTS), J41.2
/RTS: IC18.3 (/RTS), J41.6
DGND: C114.1, C115.1, C121.1, IC18.7 (GND1), IC18.18 (GND2), IC18.21 (GND3), IC18.25 (AGND), IC18.26 (TEST), J41.1, X2.4; also elsewhere on the board
unnamed: C121.2, IC18.4 (VCCIO), IC18.17 (VCC30), TP60.P$1
unnamed: D17.1+ (K), IC18.22 (GPIO0)
unnamed: D19.1+ (K), IC18.23 (GPIO1)
unnamed: D17.2 (A), R151.1
unnamed: D19.2 (A), R152.1
SBC_5V_VBUS: C114.2, C115.2, IC18.19 (/RESET), IC18.20 (VCC5I), J41.3, R151.2, R152.2, X2.1
SBC_USB_B_D_N: IC18.16 (USBDM), X2.2
SBC_USB_B_D_P: IC18.15 (USBDP), X2.3
U1RX: IC18.1 (TXD), J41.4; also elsewhere on the board
U1TX: IC18.5 (RXD), J41.5; also elsewhere on the board

Notes on the sheet:
(C) 2014 eLock Technologies, LLC -- CONFIDENTIAL
USB Hub IC
PRT_DIS_Px and PRT_DIS_Mx not pulled up => All Downstream Ports are enabled
Strapping options
BC_ENx internally pulled down => Downstream Ports do not support USB Battery Charging spec
NON_REM[1:0] = 00 => All Downstream Ports are removable.
CFG_SEL[1:0] = 00 => Strap options enabled; self-powered; individ. power switching & overcurrent sense
Should we be deleting the connector for USB port 4 and connecting the lines to the touchpad chip?
USB to serial converter
