alleybeachelectric/K3_KIOSK/BOARD FILES/PCB_KioskMB_r3.3-04.brd

## EAGLE design BOARD FILES/PCB_KioskMB_r3.3-04.brd (continued)

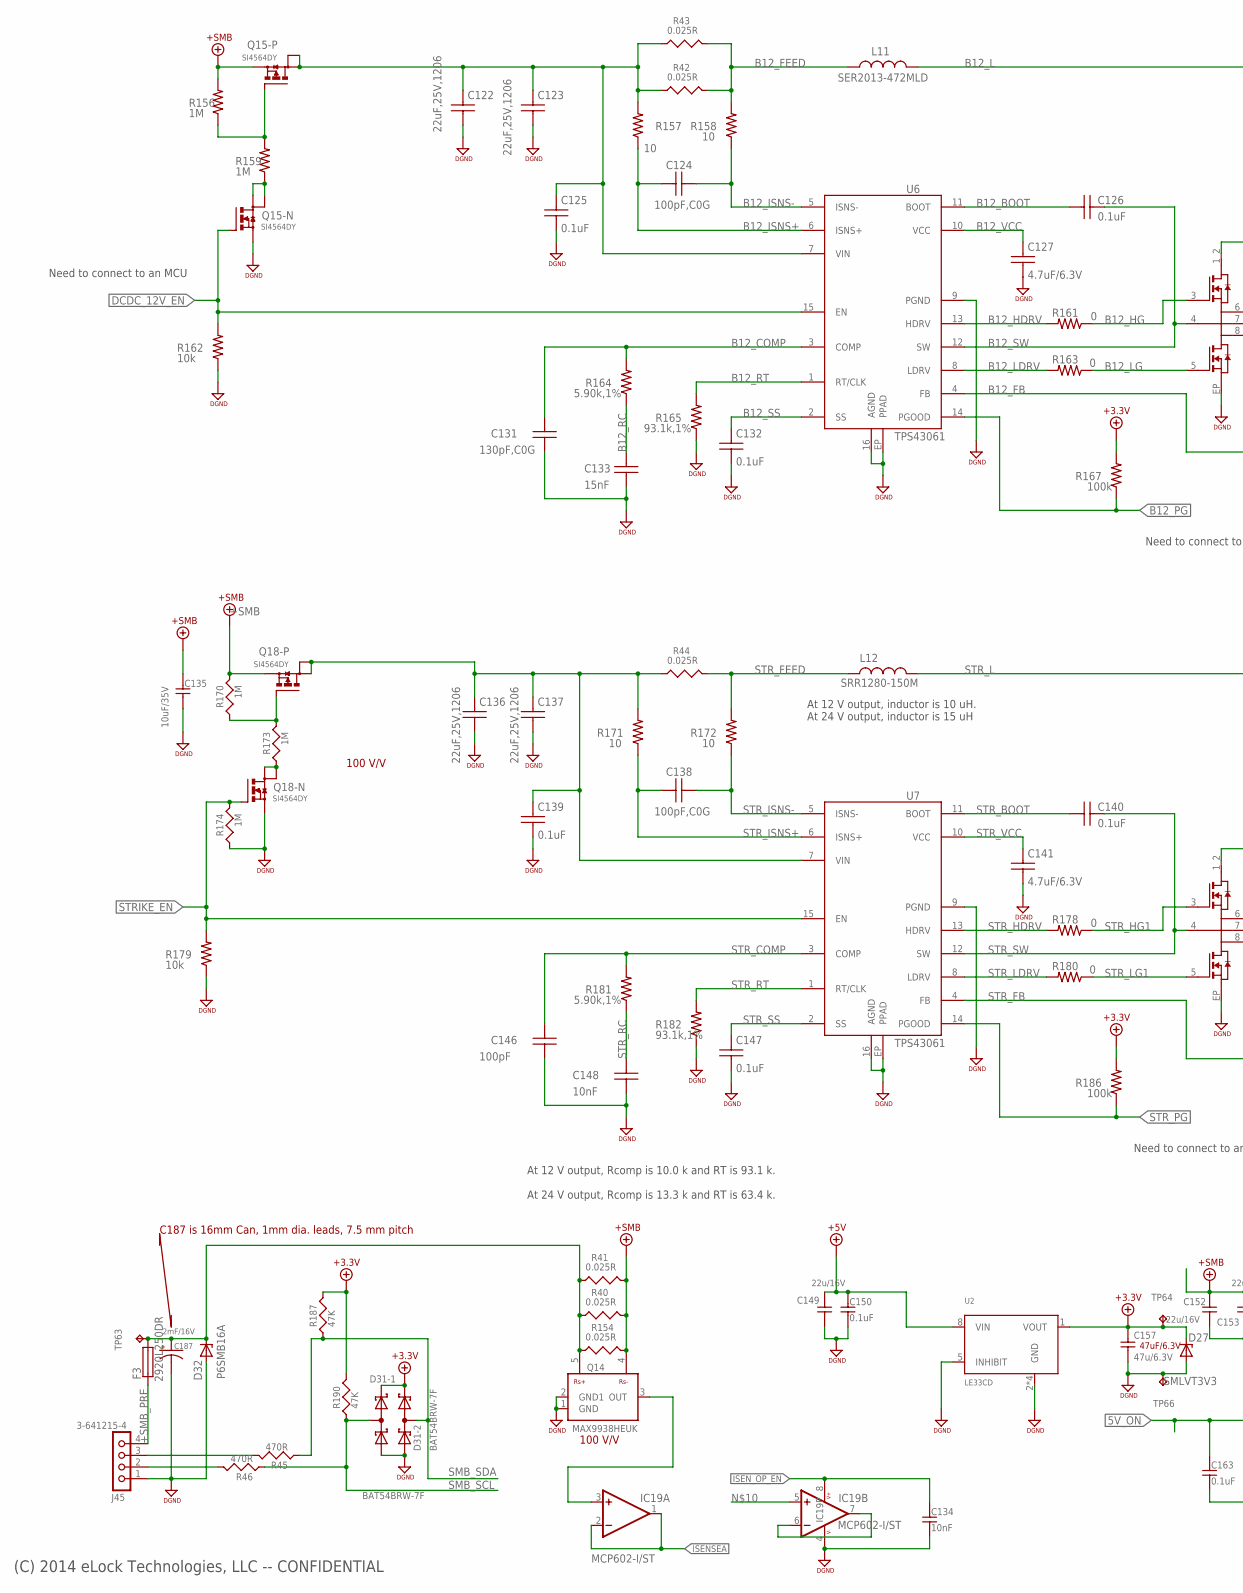
[picture p17: schematic PCB_KioskMB_r3.3-04.sch, sheet 5, part in row 1, column 1]

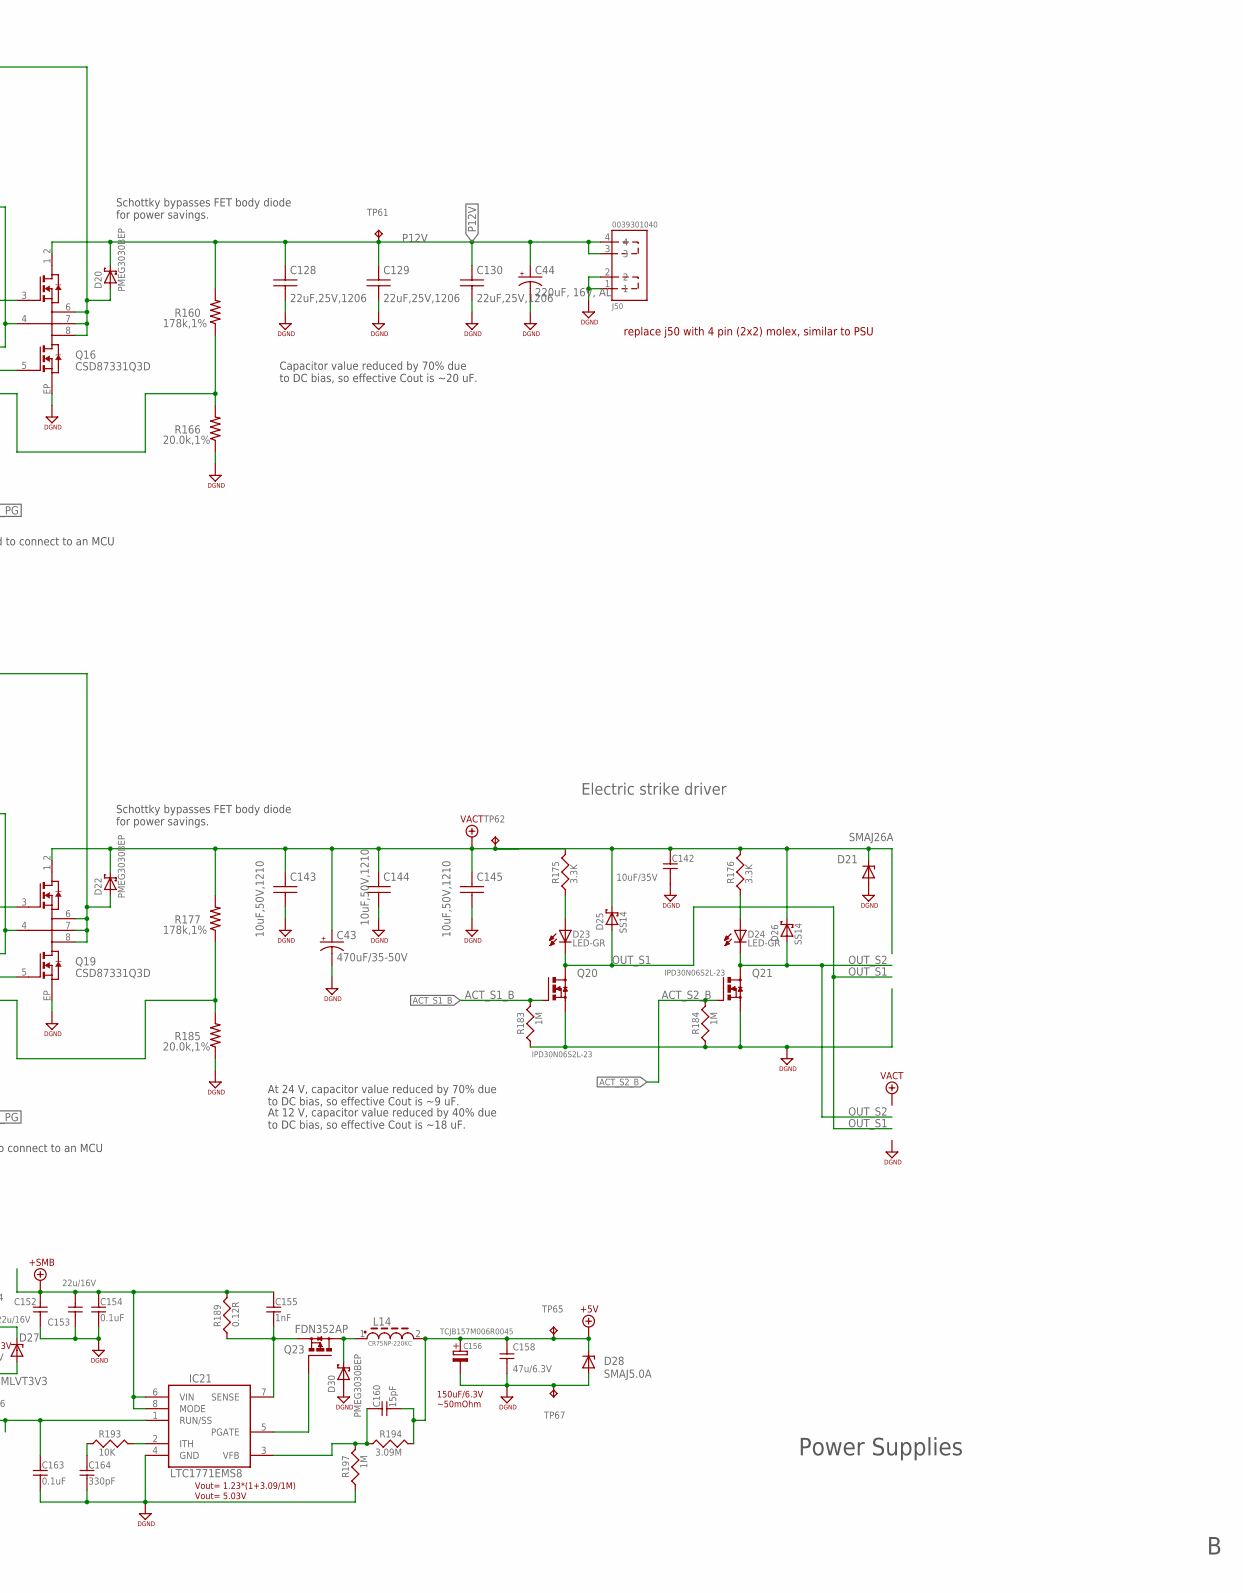
[picture p18: schematic PCB_KioskMB_r3.3-04.sch, sheet 5, part in row 1, column 2]

Parts:
C43: 470uF/35-50V; E5-13
C44: 220uF, 16V, AL; 153CLV-0605
C122, C123, C128, C129, C130, C136, C137: 22uF,25V,1206; C1206; MFR_PN CL31A226KAHNNNE
C124, C138: 100pF,C0G; C0603; MFR_PN CL10C101JB8NCNC
C125, C126, C132, C139, C140, C147: 0.1uF; C0603; MFR_PN GRM188R71H104KA93D
C127, C141: 4.7uF/6.3V; C0603; MFR_PN CL10A475KA8NQNC
C131: 130pF,C0G; C0603; MFR_PN CL10C131JB8NNNC
C133: 15nF; C0603; MFR_PN CL10B153KB8NNNC
C134: 10nF; 0603
C135, C142: 10uF/35V; 1206
C143, C144, C145: 10uF,50V,1210; C1210; MFR_PN CL32B106KBJNNWE
C146: 100pF; C0603; MFR_PN CL10C101JB8NNNC
C148: 10nF; C0603; MFR_PN CL10B103KB8NNNC
C149, C152, C153: 22u/16V; 1210
C150, C154, C163: 0.1uF; 0603
C155: 1nF; 0603
C156: TCJB157M006R0045; 3528-POL
C157, C158: 47u/6.3V; 1210
C160: 15pF; 0603
C164: 330pF; 0603
C187: 2mF/16V; E7,5-18
D20, D22, D30: PMEG3030BEP; SOD-128
D21: SMAJ26A; SMA
D23, D24: LED-GR; 0805-POL
D25, D26: SS14; SMA
D27: SMLVT3V3; SMA
D28: SMAJ5.0A; SMA
D31: BAT54BRW-7F; SOT-363
D32: P6SMB16A; SMB
F3: 2920L250DR; 1812
IC19: MCP602-I/ST; TSSOP8
IC21: LTC1771EMS8; MSOP-08
J45: 3-641215-4
J50: 0039301040
L11: SER2013-472MLD; L_SER20XX; MFR_PN SER2013-472ML
L12: SRR1280-150M; L_SRR1280; MFR_PN SRR1280-1x0M
L14: CR75NP-220KC; CR75
Q14: MAX9938HEUK; SOT23-5
Q15, Q18: SI4564DY; SO-08
Q16, Q19: CSD87331Q3D; SON8_3.3X3.3_TI; MFR_PN CSD87331Q3D
Q20, Q21: IPD30N06S2L-23; TO252
Q23: FDN352AP; SOT-23
R40, R41, R42, R43, R44, R154: 0.025R; 0805
R45, R46: 470R; 0603
R156, R159: 1M; R0603; MFR_PN ERJ-3GEYJ104V
R157, R158, R171, R172: 10; R0603; MFR_PN MCR03ERTJ100
R160, R177: 178k,1%; R0603; MFR_PN ERJ-3EKF1783V
R161, R163, R178, R180: 0; R0603; MFR_PN ERJ-3GEY0R00V
R162, R179: 10k; R0603; MFR_PN ERJ-3GEYJ103V
R164: 5.90k,1%; R0603; MFR_PN ERJ-3EKF5901V
R165: 93.1k,1%; R0603; MFR_PN ERJ-3EKF9312V
R166, R185: 20.0k,1%; R0603; MFR_PN ERJ-3EKF2002V
R167, R186: 100k; R0603; MFR_PN ERJ-3GEYJ104V
R170, R173, R174, R183, R184, R197: 1M; 0603
R175, R176: 3.3K; 0805
R181: 5.90k,1%; R0603; MFR_PN ERJ-3EKFxxxxV
R182: 93.1k,1%; R0603; MFR_PN ERJ-3EKFxxxxV
R187, R190: 47K; 0603
R189: 0.12R; 0805
R193: 10K; 0603
R194: 3.09M; 0603
TP61, TP62, TP63, TP64, TP65, TP66, TP67: TPB1,27; B1,27
U2: LE33CD; LE33
U6, U7: TPS43061; QFN16_3X3_EP

Connections:
5V_ON: C163.1, IC21.1 (RUN/SS); also elsewhere on the board
+3.3V: C157.1, D27.+ (C), D31.4 (K), D31.5 (K), R167.2, R186.2, R187.2, R190.2, TP64.TP, U2.1 (VOUT); also elsewhere on the board
+5V: C149.1, C150.1, C156.1 (PIN+), C158.1, C160.2, D28.+ (C), L14.2, R194.1, TP65.TP, U2.8 (VIN); also elsewhere on the board
+SMB: C135.1, C152.1, C153.1, C154.1, C155.1, IC21.6 (VIN), IC21.8 (MODE), Q14.4 (VIN-), Q15.3 (S), Q18.3 (S), R40.2, R41.2, R154.2, R156.2, R170.1, R189.2; also elsewhere on the board
+SMB_PRE: F3.1, J45.4; also elsewhere on the board
ACT_S1_B: Q20.1 (G), R183.1; also elsewhere on the board
ACT_S2_B: Q21.1 (G), R184.1; also elsewhere on the board
B12_BOOT: C126.1, U6.11 (BOOT)
B12_COMP: C131.1, R164.2, U6.3 (COMP)
B12_FB: R160.1, R166.2, U6.4 (FB)
B12_FEED: L11.2, R42.2, R43.2, R158.2
B12_HDRV: R161.2, U6.13 (HDRV)
B12_HG: Q16.3 (TG), R161.1
B12_ISNS+: C124.1, R157.1, U6.6 (ISNS+)
B12_ISNS-: C124.2, R158.1, U6.5 (ISNS-)
B12_L: D20.A, L11.1, Q16.6 (VSW), Q16.7 (VSW), Q16.8 (VSW)
B12_LDRV: R163.2, U6.8 (LDRV)
B12_LG: Q16.5 (BG), R163.1
B12_PG: R167.1, U6.14 (PGOOD); also elsewhere on the board
B12_RC: C133.1, R164.1
B12_RT: R165.2, U6.1 (RT/CLK)
B12_SS: C132.1, U6.2 (SS)
B12_SW: C126.2, Q16.4 (TGR), U6.12 (SW)
B12_VCC: C127.1, U6.10 (VCC)
DCDC12VIN: C122.1, C123.1, C125.1, Q15.5 (D), Q15.6 (D1), R42.1, R43.1, R157.2, U6.7 (VIN)
DCDC_12V_EN: Q15.2 (G), R162.2, U6.15 (EN); also elsewhere on the board
DGND: C43.-, C44.-, C122.2, C123.2, C125.2, C127.2, C128.2, C129.2, C130.2, C131.2, C132.2, C133.2, C134.2, C135.2, C136.2, C137.2, C139.2, C141.2, C142.2, C143.2, C144.2, C145.2, C146.2, C147.2, C148.2, C149.2, C150.2, C152.2, C153.2, C154.2, C156.2 (PIN-), C157.2, C158.2, C163.2, C164.2, C187.-, D21.- (A), D27.- (A), D28.- (A), D30.A, D31.1 (A), D31.2 (A), D32.A, IC19.4 (V-), IC21.4 (GND), J45.1, J50.1, J50.2, Q14.1 (GND), Q14.2 (GND1), Q15.1 (S), Q16.EP (PGND), Q18.1 (S), Q19.EP (PGND), Q20.2 (S), Q21.2 (S), R162.1, R165.1, R166.1, R174.2, R179.1, R182.1, R183.2, R184.2, R185.1, R197.2, TP66.TP, TP67.TP, U2.2 (GND), U2.3 (GND), U2.5 (INHIBIT), U2.6 (GND), U2.7 (GND), U6.9 (PGND), U6.16 (AGND), U6.EP (PPAD), U7.9 (PGND), U7.16 (AGND), U7.EP (PPAD); also elsewhere on the board
ISENSEA: IC19.1 (OUT), IC19.2 (-IN); also elsewhere on the board
ISEN_OP_EN: C134.1, IC19.8 (V+); also elsewhere on the board
unnamed: IC19.6 (-IN), IC19.7 (OUT)
unnamed: IC21.5 (PGATE), Q23.1 (G)
unnamed: C187.+, D32.C, F3.2, Q14.5 (VIN+), R40.1, R41.1, R154.1, TP63.TP
unnamed: IC19.3 (+IN), IC19.5 (+IN), Q14.3 (OUT)
unnamed: IC21.2 (ITH), R193.2
unnamed: C164.1, R193.1
unnamed: D30.K, L14.1, Q23.3 (D)
unnamed: C155.2, IC21.7 (SENSE), Q23.2 (S), R189.1
unnamed: Q15.4 (G), R156.1, R159.2
unnamed: C160.1, IC21.3 (VFB), R194.2, R197.1
unnamed: J45.2, R46.2
unnamed: D23.2 (A), R175.1
unnamed: D24.2 (A), R176.1
unnamed: J45.3, R45.2
unnamed: Q18.4 (G), R170.2, R173.1
unnamed: Q15.7 (D), Q15.8 (D1), R159.1
unnamed: Q18.7 (D), Q18.8 (D1), R173.2
OUT_S1: D23.1+ (K), D25.A, Q20.3 (D); also elsewhere on the board
OUT_S2: D24.1+ (K), D26.A, Q21.3 (D); also elsewhere on the board
P12V: C44.+, C128.1, C129.1, C130.1, D20.K, J50.3, J50.4, Q16.1_2 (VIN), R160.2, TP61.TP; also elsewhere on the board
SMB_SCL: D31.6 (AK), R46.1, R190.1; also elsewhere on the board
SMB_SDA: D31.3 (AK), R45.1, R187.1; also elsewhere on the board
STRIKE_EN: Q18.2 (G), R174.1, R179.2, U7.15 (EN); also elsewhere on the board
STR_BOOT: C140.1, U7.11 (BOOT)
STR_COMP: C146.1, R181.2, U7.3 (COMP)
STR_FB: R177.1, R185.2, U7.4 (FB)
STR_FEED: L12.2, R44.2, R172.2
STR_HDRV: R178.2, U7.13 (HDRV)
STR_HG1: Q19.3 (TG), R178.1
STR_ISNS+: C138.1, R171.1, U7.6 (ISNS+)
STR_ISNS-: C138.2, R172.1, U7.5 (ISNS-)
STR_L: D22.A, L12.1, Q19.6 (VSW), Q19.7 (VSW), Q19.8 (VSW)
STR_LDRV: R180.2, U7.8 (LDRV)
STR_LG1: Q19.5 (BG), R180.1
STR_PG: R186.1, U7.14 (PGOOD); also elsewhere on the board
STR_RC: C148.1, R181.1
STR_RT: R182.2, U7.1 (RT/CLK)
STR_SS: C147.1, U7.2 (SS)
STR_SW: C140.2, Q19.4 (TGR), U7.12 (SW)
STR_VCC: C141.1, U7.10 (VCC)
VACT: C43.+, C142.1, C143.1, C144.1, C145.1, D21.+ (C), D22.K, D25.C (K), D26.C (K), Q19.1_2 (VIN), R175.2, R176.2, R177.2, TP62.TP; also elsewhere on the board
VSUPLYACT: C136.1, C137.1, C139.1, Q18.5 (D), Q18.6 (D1), R44.1, R171.2, U7.7 (VIN)

Notes on the sheet:
(C) 2014 eLock Technologies, LLC -- CONFIDENTIAL
Power Supplies
Schottky bypasses FET body diode for power savings.
Capacitor value reduced by 70% due to DC bias, so effective Cout is ~20 uF.
At 24 V, capacitor value reduced by 70% due to DC bias, so effective Cout is ~9 uF.
At 12 V, capacitor value reduced by 40% due to DC bias, so effective Cout is ~18 uF.
At 12 V output, inductor is 10 uH. At 24 V output, inductor is 15 uH
At 12 V output, Rcomp is 10.0 k and RT is 93.1 k. At 24 V output, Rcomp is 13.3 k and RT is 63.4 k.
47uF/6.3V
Electric strike driver
100 V/V
Vout= 1.23*(1+3.09/1M)
Vout= 5.03V
150uF/6.3V ~50mOhm
Need to connect to an MCU
C187 is 16mm Can, 1mm dia. leads, 7.5 mm pitch
replace j50 with 4 pin (2x2) molex, similar to PSU

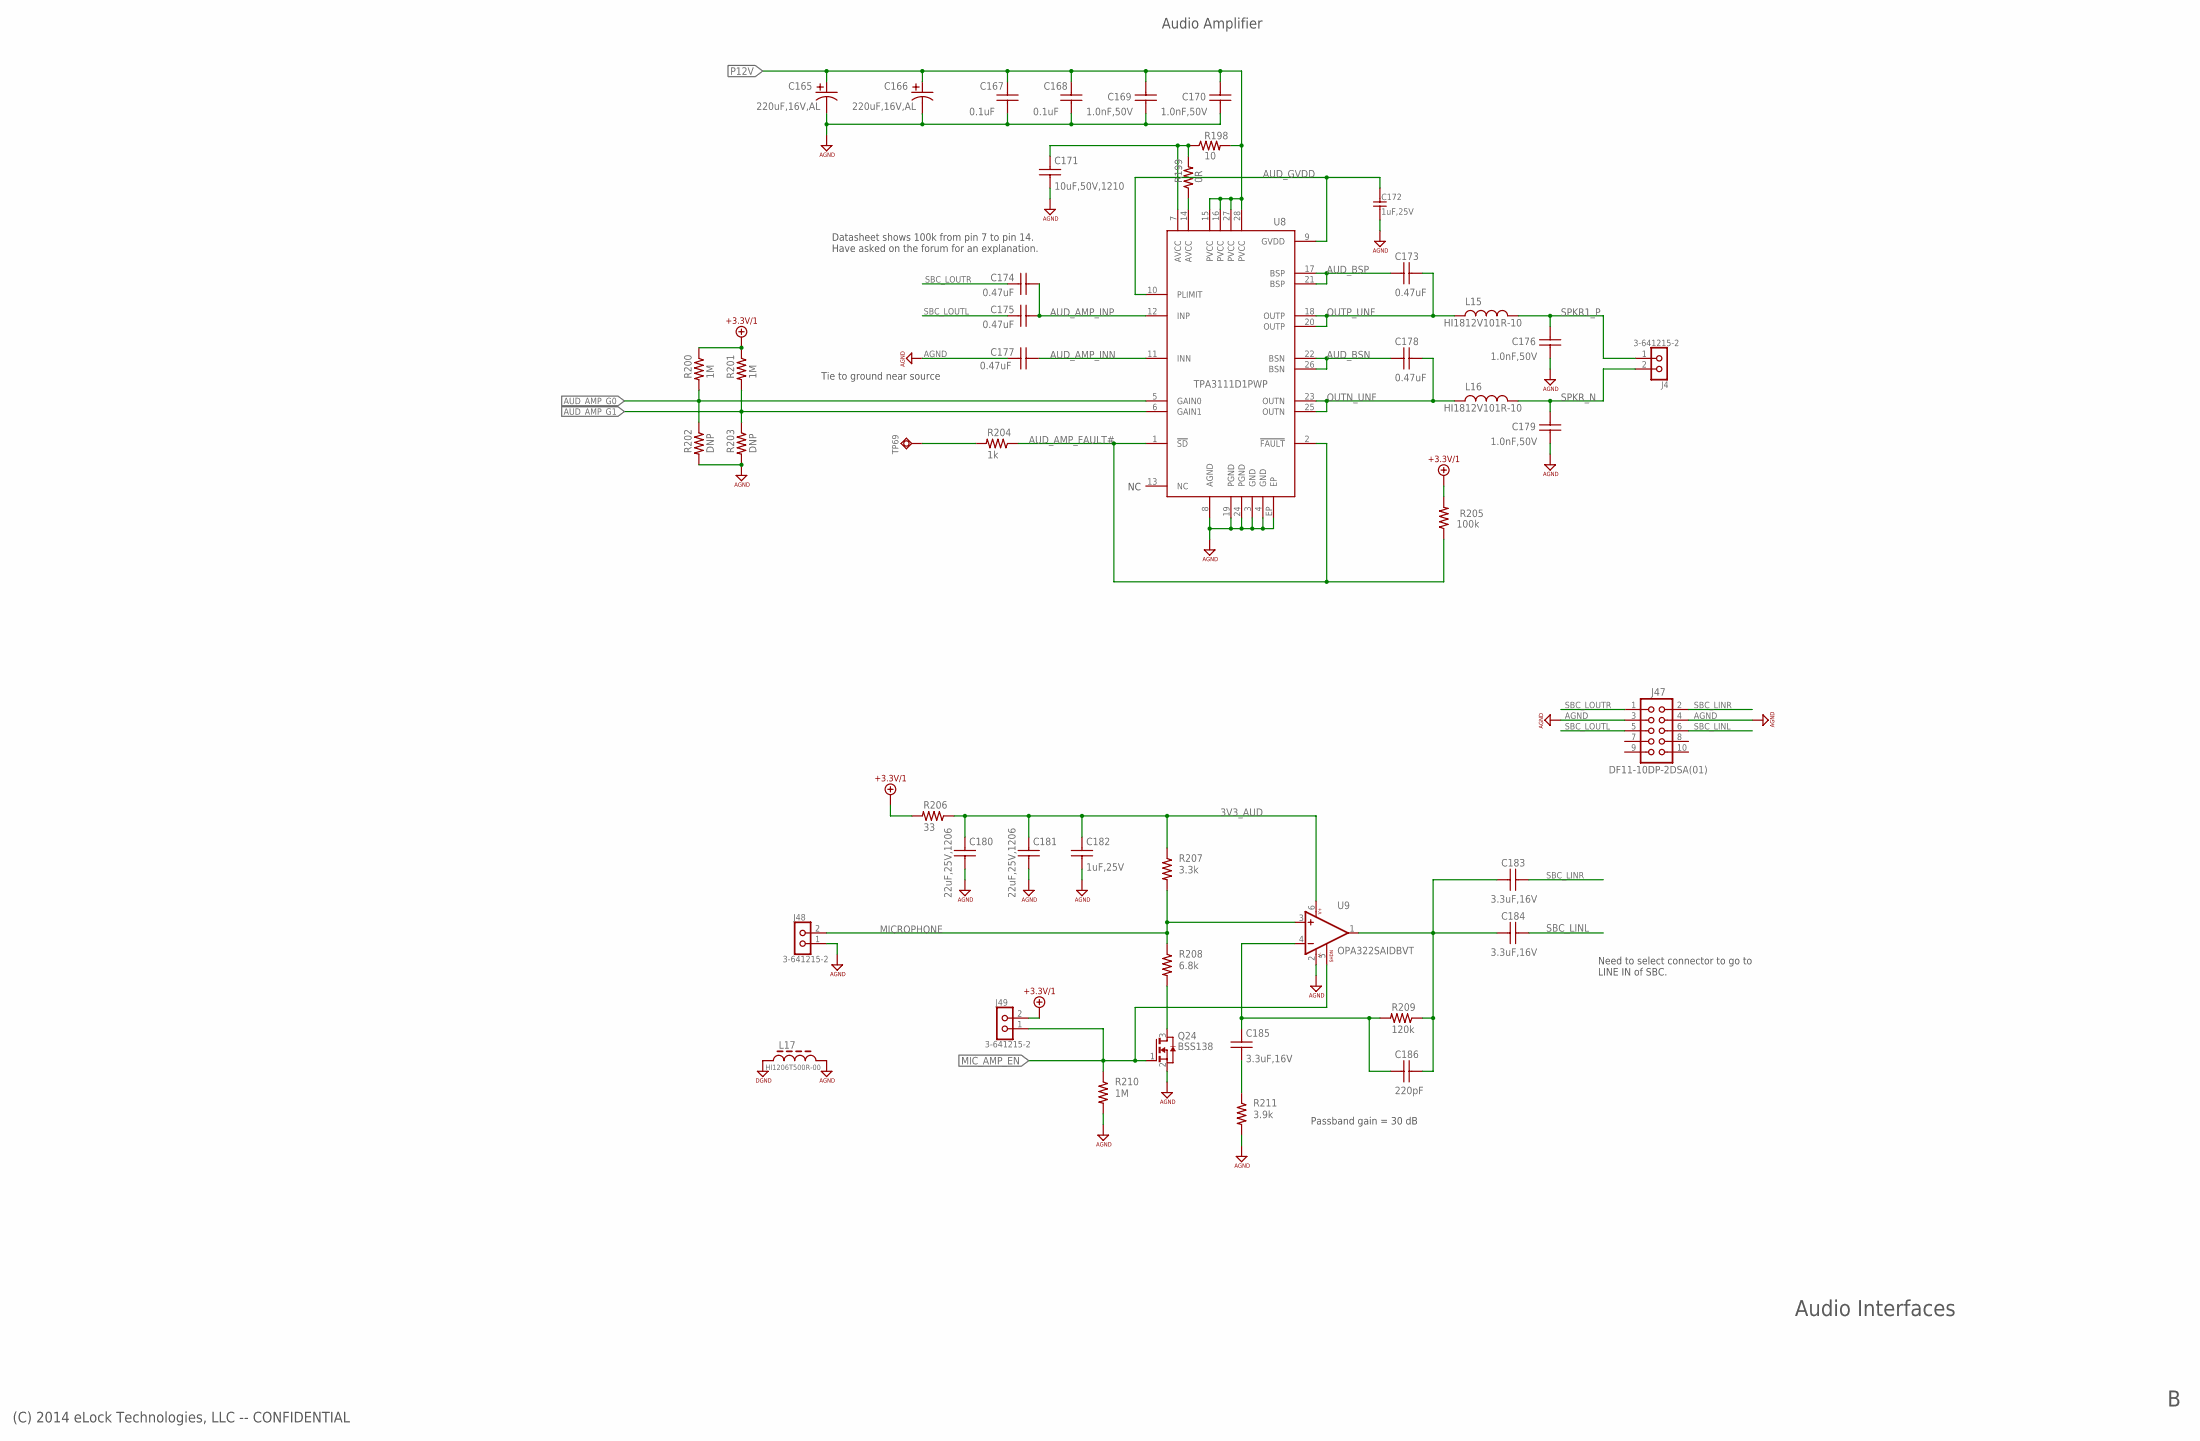
[picture p19: schematic PCB_KioskMB_r3.3-04.sch, sheet 6]

Parts:
C165, C166: 220uF,16V,AL; CAP_6.3MM_DIA_SMT; MFR_PN EEV227M016A9HAA
C167, C168: 0.1uF; C0603
C169, C170, C176, C179: 1.0nF,50V; C0603; MFR_PN CL10B102KB8NNNC
C171: 10uF,50V,1210; C1210; MFR_PN CL32B106KBJNNWE
C172: 1uF,25V; 0603
C173, C178: 0.47uF; C0603; MFR_PN TMK107B7474KA-TR
C174, C175, C177: 0.47uF; C0603; MFR_PN CL10B153KB8NNNC
C180, C181: 22uF,25V,1206; C1206; MFR_PN CL31A226KAHNNNE
C182: 1uF,25V; C0603
C183, C184, C185: 3.3uF,16V; C0603
C186: 220pF; C0603
J4, J48, J49: 3-641215-2
J47: DF11-10DP-2DSA(01); DF11-10DP-2DSA
L15, L16: HI1812V101R-10; L1812; MFR_PN HI1812V101R-10
L17: HI1206T500R-00; 1206
Q24: BSS138; SOT23
R198: 10; R0603; MFR_PN MCR03ERTJ100
R199: 0R; R0603; MFR_PN MCR03ERTJ100
R200, R201, R210: 1M; R0603
R202, R203: DNP; R0603
R204: 1k; R0603
R205: 100k; R0603
R206: 33; R0603
R207: 3.3k; R0603
R208: 6.8k; R0603
R209: 120k; R0603
R211: 3.9k; R0603
TP69: P1-13; P1-13@1
U8: TPA3111D1PWP; TSSOP28_EP
U9: OPA322SAIDBVT; SOT23-6

Connections:
3V3_AUD: C180.1, C181.1, C182.1, R206.1, R207.1, U9.6 (V+)
+3.3V/1: J49.2, R200.1, R201.1, R205.2, R206.2; also elsewhere on the board
AGND: C165.2, C166.2, C167.2, C168.2, C169.2, C170.2, C171.2, C172.2, C176.2, C177.1, C179.2, C180.2, C181.2, C182.2, J47.3, J47.4, J48.1, L17.2, Q24.2 (S), R202.2, R203.2, R210.2, R211.2, U8.3 (GND), U8.4 (GND), U8.8 (AGND), U8.19 (PGND), U8.24 (PGND), U8.EP, U9.2 (V-); also elsewhere on the board
AUD_AMP_FAULT#: R204.1, R205.1, U8.1 (!SD), U8.2 (!FAULT)
AUD_AMP_G0: R200.2, R202.1, U8.5 (GAIN0); also elsewhere on the board
AUD_AMP_G1: R201.2, R203.1, U8.6 (GAIN1); also elsewhere on the board
AUD_AMP_INN: C177.2, U8.11 (INN)
AUD_AMP_INP: C174.2, C175.2, U8.12 (INP)
AUD_AMP_SD#: R204.2, TP69.1
AUD_BSN: C178.1, U8.22 (BSN), U8.26 (BSN)
AUD_BSP: C173.1, U8.17 (BSP), U8.21 (BSP)
AUD_GVDD: C172.1, U8.9 (GVDD), U8.10 (PLIMIT)
DGND: L17.1; also elsewhere on the board
MICROPHONE: J48.2, R207.2, R208.1, U9.3 (+IN); also elsewhere on the board
MIC_AMP_EN: J49.1, Q24.1 (G), R210.1, U9.5 (!SHDN); also elsewhere on the board
unnamed: R199.1, U8.14 (AVCC)
unnamed: C171.1, R198.1, R199.2, U8.7 (AVCC)
unnamed: C185.2, R211.1
unnamed: C185.1, C186.1, R209.2, U9.4 (-IN)
unnamed: C183.1, C184.1, C186.2, R209.1, U9.1 (OUT)
unnamed: Q24.3 (D), R208.2
OUTN_UNF: C178.2, L16.2, U8.23 (OUTN), U8.25 (OUTN)
OUTP_UNF: C173.2, L15.2, U8.18 (OUTP), U8.20 (OUTP)
P12V: C165.1, C166.1, C167.1, C168.1, C169.1, C170.1, R198.2, U8.15 (PVCC), U8.16 (PVCC), U8.27 (PVCC), U8.28 (PVCC); also elsewhere on the board
SBC_LINL: C184.2, J47.6; also elsewhere on the board
SBC_LINR: C183.2, J47.2; also elsewhere on the board
SBC_LOUTL: C175.1, J47.5; also elsewhere on the board
SBC_LOUTR: C174.1, J47.1; also elsewhere on the board
SPKR1_P: C176.1, J4.1, L15.1; also elsewhere on the board
SPKR_N: C179.1, J4.2, L16.1; also elsewhere on the board

Notes on the sheet:
(C) 2014 eLock Technologies, LLC -- CONFIDENTIAL
Audio Interfaces
Tie to ground near source
Datasheet shows 100k from pin 7 to pin 14. Have asked on the forum for an explanation.
Audio Amplifier
Passband gain = 30 dB
Need to select connector to go to LINE IN of SBC.

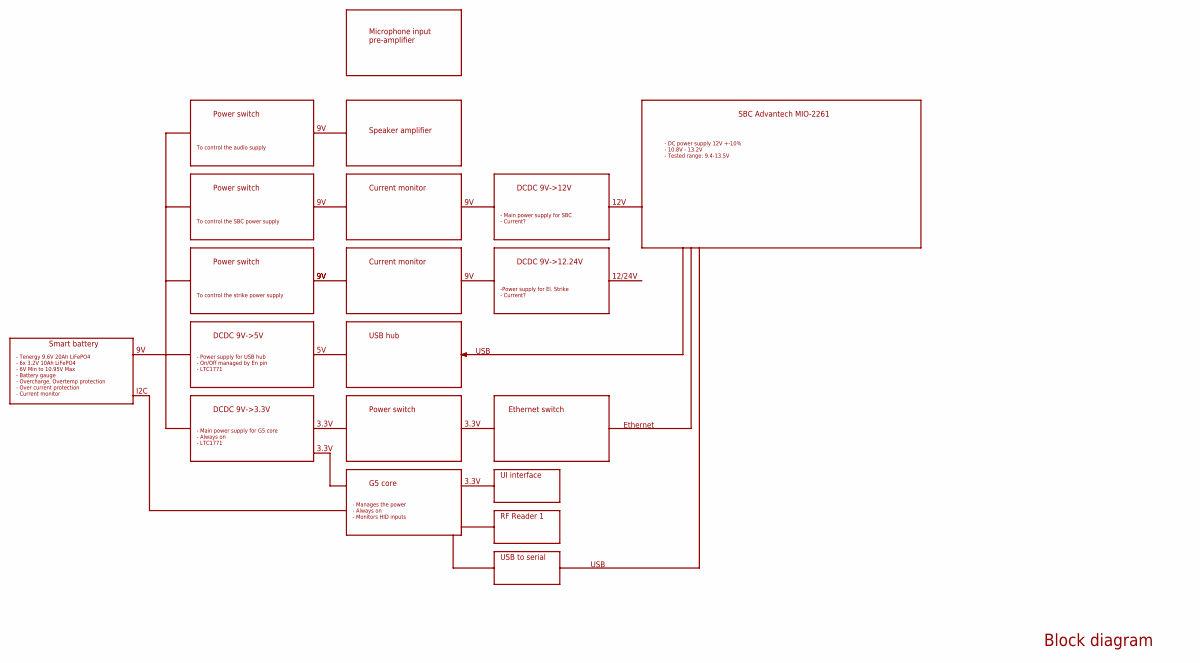
[picture p20: schematic PCB_KioskMB_r3.3-04.sch, sheet 7]

Notes on the sheet:
Block diagram
SBC Advantech MIO-2261
Microphone input pre-amplifier
Speaker amplifier
Smart battery
- Tenergy 9.6V 20Ah LiFePO4 - 6x 3.2V 10Ah LiFePO4 - 6V Min to 10.95V Max - Battery gauge - Overcharge, Overtemp protection - Over current protection - Current monitor
I2C
DCDC 9V->12V
- Main power supply for SBC - Current?
- DC power supply 12V +-10% - 10.8V - 13.2V - Tested range: 9.4-13.5V
Power switch
To control the SBC power supply
12V
DCDC 9V->5V
- Power supply for USB hub - On/Off managed by En pin - LTC1771
DCDC 9V->12.24V
-Power supply for El. Strike - Current?
12/24V
To control the strike power supply
Current monitor
DCDC 9V->3.3V
- Main power supply for G5 core - Always on - LTC1771
3.3V
G5 core
- Manages the power - Always on - Monitors HID inputs
UI interface
RF Reader 1
USB hub
To control the audio supply
Ethernet switch
USB
Ethernet
USB to serial

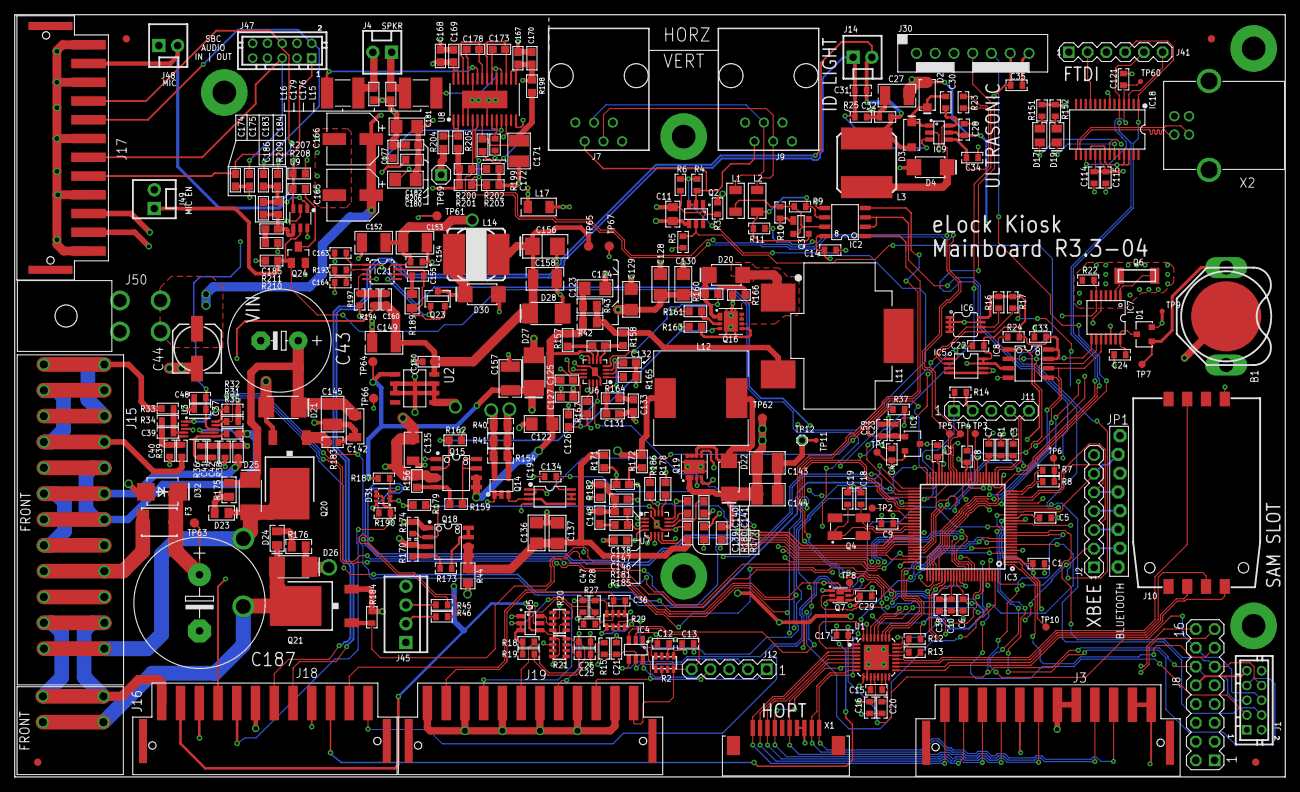
[picture p21: board PCB_KioskMB_r3.3-04.brd from above]

Board: 4 copper layers, 172.1 x 103.3 mm, 328 parts (0 on the bottom side), 222 nets.

Other parts of the board:
DRILEGEND: DRILEGEND
