alleybeachelectric/K3_KIOSK/(commit log)

2017-05-10 initial commit.
    [PCB_KioskMB_r3.2.brd, PCB_KioskMB_r3.2.sch]
2017-05-15 getting closer.
    [PCB_KioskMB_r3.2.brd]
2017-05-18 almost there again. fixed FPC connector to be 1.00mm pitch.
    [PCB_KioskMB_r3.2- fixed FPC connector.dxf, PCB_KioskMB_r3.2.dxf, PCB_KioskMB_r3.2.sch]
2017-05-18 save state 12:27pm
    save state 12:27pm
    [PCB_KioskMB_r3.2.brd]
2017-05-23 update from thursday
    update from thursday
    [PCB_KioskMB_r3.2.brd]
2017-05-29 added BOM to csv
    [PCB_KioskMB_r3.2.brd, PCB_KioskMB_r3.2.csv]
2017-05-29 cleaned up silk
    [PCB_KioskMB_r3.2.brd, PCB_KioskMB_r3.2.csv, PCB_KioskMB_r3.2.sch]
2017-05-30 updated BOM
    [PCB_KioskMB_r3.2.csv, PCB_KioskMB_r3.2.xlsm]
2017-06-30 added components ( for sbc power) and updated lan components.
    [PCB_KioskMB_r3.2.brd, PCB_KioskMB_r3.2.csv, PCB_KioskMB_r3.2.sch, PCB_KioskMB_r3.2.xlsm]
2017-06-30 ADDED SILK
    [PCB_KioskMB_r3.2.brd]
2017-07-04 update connectors
    USB B connector, VREF design, connectors.
    [DRILEGEND.CFG, PCB_KioskMB_r3.2.brd, PCB_KioskMB_r3.2.xlsm]
2017-07-04 added molex connector
    [PCB_KioskMB_r3.2.sch]
2017-07-04 push latest
    [PCB_KioskMB_r3.2.brd, PCB_KioskMB_r3.2.sch]
2017-07-06 new rev number
    major changes, reviewed all of Jarv's notes and applied them. started changing connectors.
    [PCB_KioskMB_r3.2.brd, PCB_KioskMB_r3.2.sch, PCB_KioskMB_r3.2.xlsm, PCB_KioskMB_r3.3.brd, PCB_KioskMB_r3.3.sch]
2017-07-07 :+1:
    :P
    [PCB_KioskMB_r3.3.brd]
2017-07-07 added .png of connectors.
    [PCB_KioskMB_r3.3-02.brd, PCB_KioskMB_r3.3-02.sch, PCB_KioskMB_r3.3.brd, PCB_KioskMB_r3.3.sch]
2017-07-10 finished routing. cleaned up top silk
    [PCB_KioskMB_r3.3-03.brd, PCB_KioskMB_r3.3-03.sch]
2017-07-11 finalized bottom silk
    finalized bottom silk, added 8 different revisions of bottom silk. added icons to match solar charger controller
    [PCB_KioskMB_r3.3-03.brd]
2017-07-11 added fab file release folder and gerbers
    [PCB_KioskMB_r3.3-04.GBL, PCB_KioskMB_r3.3-04.GBO, PCB_KioskMB_r3.3-04.GBS, PCB_KioskMB_r3.3-04.GKO, PCB_KioskMB_r3.3-04.GTL, PCB_KioskMB_r3.3-04.GTO, PCB_KioskMB_r3.3-04.GTP, PCB_KioskMB_r3.3-04.GTS]
2017-07-12 on r3.3-05
    [PCB_KioskMB_r3.3-05.GBL, PCB_KioskMB_r3.3-05.GBO, PCB_KioskMB_r3.3-05.GBS, PCB_KioskMB_r3.3-05.GKO, PCB_KioskMB_r3.3-05.GTL, PCB_KioskMB_r3.3-05.GTO, PCB_KioskMB_r3.3-05.GTP, PCB_KioskMB_r3.3-05.GTS]
2017-08-18 added 3.4
    [PCB_KioskMB_r3.4-01.brd, PCB_KioskMB_r3.4-01.sch]
2018-03-08 cleaned up repo
    [DRILEGEND.CFG, PCB_KioskMB_r3.2- fixed FPC connector.dxf, PCB_KioskMB_r3.2.brd, PCB_KioskMB_r3.2.csv, PCB_KioskMB_r3.2.dxf, PCB_KioskMB_r3.2.sch, PCB_KioskMB_r3.2.xlsm, PCB_KioskMB_r3.3-02.brd]
