alleybeachelectric/K3_KIOSK/(notices)

Notices in the files:
BOARD FILES/PCB_KioskMB_r3.3-02.brd:
Copyright (C) 2015
parts and their libraries:
SparkFun-Hardware: Licensing: Creative Commons ShareAlike 4.0 International - https://creativecommons.org/licenses/by-sa/4.0
